Fundacion-Fulgor/IHP__CDR4176/doc/fig/PI_Timeline.png

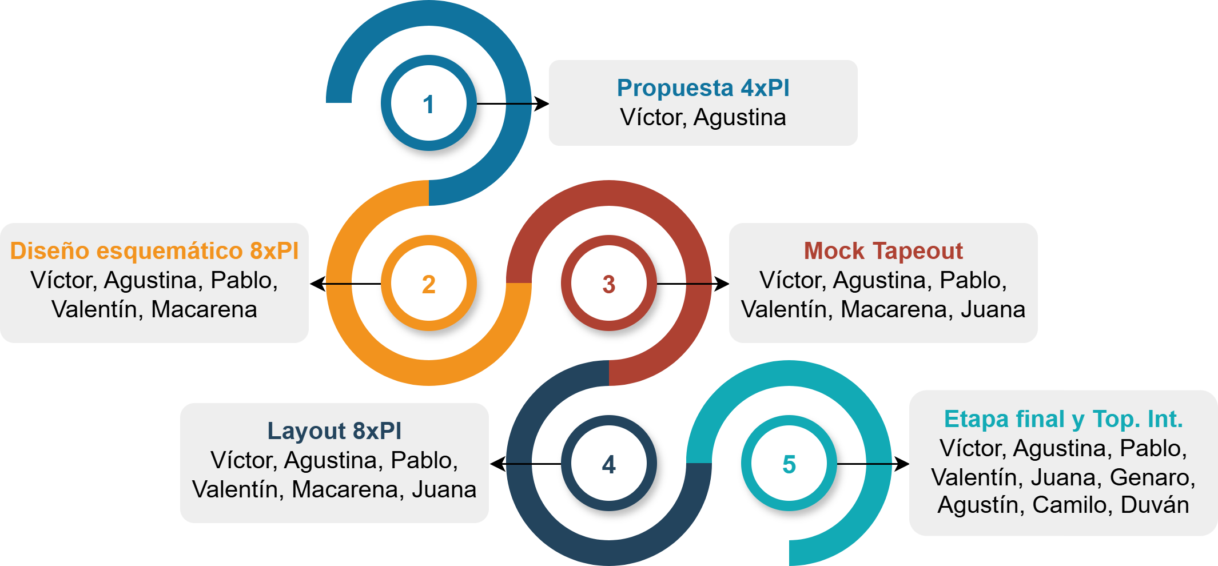
doc/fig/PI_Timeline.png
