Fundacion-Fulgor/IHP__CDR4176/CDR4176-main/schematic/xschem/MUX_4_1_CDR/MUX_4_1_CDR_pex.spice

* NGSPICE file created from MUX_4_1.ext - technology: ihp-sg13g2

.subckt MUX_4_1_CDR_pex VINA VINB VDD VOUT VS[1] VS[0] VINC VSS VIND VST
X0 MUX_2_1_2.tg_custom_6.VOUT MUX_2_1_2.tg_custom_6.VSN.t1 MUX_2_1_2.inv_PI_1.VOUT VSS sg13_lv_nmos ad=0.1005p pd=1.34u as=0.1005p ps=1.34u w=0.15u l=0.13u
X1 MUX_2_1_2.inv_PI_0.VOUT VINA.t0 VDD VDD sg13_lv_pmos ad=55.5f pd=0.74u as=0.1005p ps=1.34u w=0.15u l=0.13u
X2 MUX_2_1_0.inv_PI_1.VOUT MUX_2_1_0.tg_custom_6.VSP.t1 MUX_2_1_0.tg_custom_6.VOUT VDD sg13_lv_pmos ad=0.1005p pd=1.34u as=55.5f ps=0.74u w=0.15u l=0.13u
X3 MUX_2_1_0.VINB MUX_2_1_1.tg_custom_6.VSP.t1 MUX_2_1_1.tg_custom_2.VOUT VSS sg13_lv_nmos ad=0.1005p pd=1.34u as=0.1005p ps=1.34u w=0.15u l=0.13u
X4 a_10276_981# a_10276_981# VSS VSS sg13_lv_nmos ad=0.1005p pd=1.34u as=0.1005p ps=1.34u w=0.15u l=0.13u
X5 VDD VINA.t0 MUX_2_1_2.inv_PI_0.VOUT VDD sg13_lv_pmos ad=55.5f pd=0.74u as=55.5f ps=0.74u w=0.15u l=0.13u
X6 MUX_2_1_2.inv_PI_0.VOUT MUX_2_1_2.tg_custom_6.VSP.t1 MUX_2_1_2.tg_custom_2.VOUT VDD sg13_lv_pmos ad=0.1005p pd=1.34u as=55.5f ps=0.74u w=0.15u l=0.13u
X7 MUX_2_1_2.tg_custom_2.VOUT MUX_2_1_2.tg_custom_4.VSP MUX_2_1_2.inv_PI_0.VOUT VSS sg13_lv_nmos ad=0.1005p pd=1.34u as=0.1005p ps=1.34u w=0.15u l=0.13u
X8 MUX_2_1_1.tg_custom_2.VOUT VS[1].t0 MUX_2_1_1.inv_PI_0.VOUT VDD sg13_lv_pmos ad=55.5f pd=0.74u as=0.1005p ps=1.34u w=0.15u l=0.13u
X9 MUX_2_1_1.inv_PI_0.VOUT VINC.t0 VDD VDD sg13_lv_pmos ad=0.1005p pd=1.34u as=55.5f ps=0.74u w=0.15u l=0.13u
X10 MUX_2_1_1.tg_custom_6.VOUT MUX_2_1_1.tg_custom_4.VSP MUX_2_1_1.inv_PI_1.VOUT VDD sg13_lv_pmos ad=55.5f pd=0.74u as=0.1005p ps=1.34u w=0.15u l=0.13u
X11 MUX_2_1_2.tg_custom_6.VOUT MUX_2_1_2.tg_custom_4.VSP MUX_2_1_2.inv_PI_1.VOUT VDD sg13_lv_pmos ad=55.5f pd=0.74u as=0.1005p ps=1.34u w=0.15u l=0.13u
X12 MUX_2_1_0.inv_PI_0.VOUT MUX_2_1_0.VINA VDD VDD sg13_lv_pmos ad=55.5f pd=0.74u as=0.1005p ps=1.34u w=0.15u l=0.13u
X13 MUX_2_1_0.tg_custom_2.VOUT MUX_2_1_0.tg_custom_4.VSP MUX_2_1_0.inv_PI_0.VOUT VSS sg13_lv_nmos ad=0.1005p pd=1.34u as=0.1005p ps=1.34u w=0.15u l=0.13u
X14 VSS VINA.t0 MUX_2_1_2.inv_PI_0.VOUT VSS sg13_lv_nmos ad=0.1005p pd=1.34u as=55.5f ps=0.74u w=0.15u l=0.13u
X15 MUX_2_1_0.tg_custom_4.VSP VST.t0 VSS VSS sg13_lv_nmos ad=0.1005p pd=1.34u as=0.1005p ps=1.34u w=0.15u l=0.13u
X16 MUX_2_1_0.tg_custom_6.VOUT MUX_2_1_0.tg_custom_4.VSP MUX_2_1_0.inv_PI_1.VOUT VDD sg13_lv_pmos ad=55.5f pd=0.74u as=0.1005p ps=1.34u w=0.15u l=0.13u
X17 VOUT.t3 MUX_2_1_0.tg_custom_6.VSN.t1 MUX_2_1_0.tg_custom_2.VOUT VDD sg13_lv_pmos ad=55.5f pd=0.74u as=0.1005p ps=1.34u w=0.15u l=0.13u
X18 MUX_2_1_0.tg_custom_6.VSP.t0 a_13178_1682# VDD VDD sg13_lv_pmos ad=0.1005p pd=1.34u as=0.1005p ps=1.34u w=0.15u l=0.13u
X19 MUX_2_1_1.inv_PI_1.VOUT MUX_2_1_1.tg_custom_6.VSP.t2 MUX_2_1_1.tg_custom_6.VOUT VDD sg13_lv_pmos ad=0.1005p pd=1.34u as=55.5f ps=0.74u w=0.15u l=0.13u
X20 VSS MUX_2_1_0.VINA MUX_2_1_0.inv_PI_0.VOUT VSS sg13_lv_nmos ad=0.1005p pd=1.34u as=55.5f ps=0.74u w=0.15u l=0.13u
X21 VDD VIND.t0 MUX_2_1_1.inv_PI_1.VOUT VDD sg13_lv_pmos ad=55.5f pd=0.74u as=55.5f ps=0.74u w=0.15u l=0.13u
X22 MUX_2_1_1.tg_custom_6.VSN.t0 a_10276_280# VSS VSS sg13_lv_nmos ad=0.1005p pd=1.34u as=0.1005p ps=1.34u w=0.15u l=0.13u
X23 MUX_2_1_0.inv_PI_1.VOUT MUX_2_1_0.VINB VSS VSS sg13_lv_nmos ad=55.5f pd=0.74u as=0.1005p ps=1.34u w=0.15u l=0.13u
X24 MUX_2_1_0.VINA MUX_2_1_2.tg_custom_6.VSP.t2 MUX_2_1_2.tg_custom_6.VOUT VSS sg13_lv_nmos ad=0.1005p pd=1.34u as=0.1005p ps=1.34u w=0.15u l=0.13u
X25 MUX_2_1_2.tg_custom_6.VSN.t0 a_10276_1682# VSS VSS sg13_lv_nmos ad=0.1005p pd=1.34u as=0.1005p ps=1.34u w=0.15u l=0.13u
X26 MUX_2_1_2.tg_custom_2.VOUT MUX_2_1_2.tg_custom_6.VSN.t2 MUX_2_1_2.inv_PI_0.VOUT VSS sg13_lv_nmos ad=0.1005p pd=1.34u as=0.1005p ps=1.34u w=0.15u l=0.13u
X27 MUX_2_1_1.tg_custom_2.VOUT MUX_2_1_1.tg_custom_6.VSN.t1 MUX_2_1_0.VINB VDD sg13_lv_pmos ad=0.1005p pd=1.34u as=55.5f ps=0.74u w=0.15u l=0.13u
X28 MUX_2_1_1.tg_custom_2.VOUT MUX_2_1_1.tg_custom_6.VSP.t3 MUX_2_1_1.inv_PI_0.VOUT VDD sg13_lv_pmos ad=55.5f pd=0.74u as=0.1005p ps=1.34u w=0.15u l=0.13u
X29 MUX_2_1_2.tg_custom_4.VSP VS[0].t0 VDD VDD sg13_lv_pmos ad=0.1005p pd=1.34u as=0.1005p ps=1.34u w=0.15u l=0.13u
X30 MUX_2_1_1.inv_PI_1.VOUT MUX_2_1_1.tg_custom_4.VSP MUX_2_1_1.tg_custom_6.VOUT VDD sg13_lv_pmos ad=0.1005p pd=1.34u as=55.5f ps=0.74u w=0.15u l=0.13u
X31 MUX_2_1_0.VINB MUX_2_1_1.tg_custom_6.VSN.t2 MUX_2_1_1.tg_custom_6.VOUT VDD sg13_lv_pmos ad=55.5f pd=0.74u as=0.1005p ps=1.34u w=0.15u l=0.13u
X32 MUX_2_1_2.tg_custom_2.VOUT VS[0].t1 MUX_2_1_2.inv_PI_0.VOUT VDD sg13_lv_pmos ad=55.5f pd=0.74u as=0.1005p ps=1.34u w=0.15u l=0.13u
X33 MUX_2_1_0.inv_PI_0.VOUT VST.t1 MUX_2_1_0.tg_custom_2.VOUT VDD sg13_lv_pmos ad=0.1005p pd=1.34u as=55.5f ps=0.74u w=0.15u l=0.13u
X34 MUX_2_1_0.tg_custom_6.VOUT MUX_2_1_0.tg_custom_6.VSN.t2 MUX_2_1_0.inv_PI_1.VOUT VSS sg13_lv_nmos ad=0.1005p pd=1.34u as=0.1005p ps=1.34u w=0.15u l=0.13u
X35 MUX_2_1_1.inv_PI_0.VOUT VINC.t0 VSS VSS sg13_lv_nmos ad=55.5f pd=0.74u as=0.1005p ps=1.34u w=0.15u l=0.13u
X36 MUX_2_1_1.inv_PI_0.VOUT VS[1].t1 MUX_2_1_1.tg_custom_2.VOUT VDD sg13_lv_pmos ad=0.1005p pd=1.34u as=55.5f ps=0.74u w=0.15u l=0.13u
X37 MUX_2_1_2.inv_PI_1.VOUT VINB.t0 VDD VDD sg13_lv_pmos ad=0.1005p pd=1.34u as=55.5f ps=0.74u w=0.15u l=0.13u
X38 MUX_2_1_2.tg_custom_6.VOUT MUX_2_1_2.tg_custom_6.VSP.t3 MUX_2_1_2.inv_PI_1.VOUT VDD sg13_lv_pmos ad=55.5f pd=0.74u as=0.1005p ps=1.34u w=0.15u l=0.13u
X39 MUX_2_1_1.inv_PI_1.VOUT VIND.t0 VDD VDD sg13_lv_pmos ad=55.5f pd=0.74u as=0.1005p ps=1.34u w=0.15u l=0.13u
X40 MUX_2_1_1.inv_PI_1.VOUT VIND.t0 VDD VDD sg13_lv_pmos ad=0.1005p pd=1.34u as=55.5f ps=0.74u w=0.15u l=0.13u
X41 MUX_2_1_0.tg_custom_6.VOUT MUX_2_1_0.tg_custom_6.VSP.t1 MUX_2_1_0.inv_PI_1.VOUT VDD sg13_lv_pmos ad=55.5f pd=0.74u as=0.1005p ps=1.34u w=0.15u l=0.13u
X42 MUX_2_1_0.inv_PI_1.VOUT MUX_2_1_0.VINB VDD VDD sg13_lv_pmos ad=0.1005p pd=1.34u as=55.5f ps=0.74u w=0.15u l=0.13u
X43 MUX_2_1_1.tg_custom_6.VOUT MUX_2_1_1.tg_custom_6.VSP.t4 MUX_2_1_1.inv_PI_1.VOUT VDD sg13_lv_pmos ad=55.5f pd=0.74u as=0.1005p ps=1.34u w=0.15u l=0.13u
X44 MUX_2_1_0.tg_custom_2.VOUT VST.t2 MUX_2_1_0.inv_PI_0.VOUT VDD sg13_lv_pmos ad=55.5f pd=0.74u as=0.1005p ps=1.34u w=0.15u l=0.13u
X45 MUX_2_1_0.inv_PI_1.VOUT MUX_2_1_0.tg_custom_6.VSP.t2 MUX_2_1_0.tg_custom_6.VOUT VDD sg13_lv_pmos ad=0.1005p pd=1.34u as=55.5f ps=0.74u w=0.15u l=0.13u
X46 MUX_2_1_1.tg_custom_6.VOUT MUX_2_1_1.tg_custom_6.VSN.t2 MUX_2_1_0.VINB VDD sg13_lv_pmos ad=0.1005p pd=1.34u as=55.5f ps=0.74u w=0.15u l=0.13u
X47 MUX_2_1_0.inv_PI_0.VOUT MUX_2_1_0.VINA VSS VSS sg13_lv_nmos ad=55.5f pd=0.74u as=0.1005p ps=1.34u w=0.15u l=0.13u
X48 MUX_2_1_1.tg_custom_4.VSP VS[1].t2 VSS VSS sg13_lv_nmos ad=0.1005p pd=1.34u as=0.1005p ps=1.34u w=0.15u l=0.13u
X49 a_10276_2383# a_10276_2383# VSS VSS sg13_lv_nmos ad=0.1005p pd=1.34u as=0.1005p ps=1.34u w=0.15u l=0.13u
X50 MUX_2_1_0.VINA MUX_2_1_2.tg_custom_6.VSP.t4 MUX_2_1_2.tg_custom_2.VOUT VSS sg13_lv_nmos ad=0.1005p pd=1.34u as=0.1005p ps=1.34u w=0.15u l=0.13u
X51 MUX_2_1_0.VINB MUX_2_1_1.tg_custom_6.VSN.t1 MUX_2_1_1.tg_custom_2.VOUT VDD sg13_lv_pmos ad=55.5f pd=0.74u as=0.1005p ps=1.34u w=0.15u l=0.13u
X52 MUX_2_1_1.tg_custom_6.VSP.t0 a_10276_981# VDD VDD sg13_lv_pmos ad=0.1005p pd=1.34u as=0.1005p ps=1.34u w=0.15u l=0.13u
X53 MUX_2_1_1.tg_custom_2.VOUT MUX_2_1_1.tg_custom_4.VSP MUX_2_1_1.inv_PI_0.VOUT VSS sg13_lv_nmos ad=0.1005p pd=1.34u as=0.1005p ps=1.34u w=0.15u l=0.13u
X54 MUX_2_1_2.tg_custom_6.VOUT MUX_2_1_2.tg_custom_6.VSN.t3 MUX_2_1_0.VINA VDD sg13_lv_pmos ad=0.1005p pd=1.34u as=55.5f ps=0.74u w=0.15u l=0.13u
X55 MUX_2_1_0.tg_custom_2.VOUT MUX_2_1_0.tg_custom_6.VSN.t3 MUX_2_1_0.inv_PI_0.VOUT VSS sg13_lv_nmos ad=0.1005p pd=1.34u as=0.1005p ps=1.34u w=0.15u l=0.13u
X56 MUX_2_1_2.tg_custom_6.VOUT MUX_2_1_2.tg_custom_6.VSP.t5 MUX_2_1_2.inv_PI_1.VOUT VDD sg13_lv_pmos ad=55.5f pd=0.74u as=0.1005p ps=1.34u w=0.15u l=0.13u
X57 MUX_2_1_2.inv_PI_1.VOUT VINB.t0 VSS VSS sg13_lv_nmos ad=55.5f pd=0.74u as=0.1005p ps=1.34u w=0.15u l=0.13u
X58 MUX_2_1_2.inv_PI_0.VOUT VINA.t0 VDD VDD sg13_lv_pmos ad=0.1005p pd=1.34u as=55.5f ps=0.74u w=0.15u l=0.13u
X59 MUX_2_1_2.tg_custom_2.VOUT VS[0].t2 MUX_2_1_2.inv_PI_0.VOUT VDD sg13_lv_pmos ad=55.5f pd=0.74u as=0.1005p ps=1.34u w=0.15u l=0.13u
X60 VOUT.t0 MUX_2_1_0.tg_custom_6.VSP.t3 MUX_2_1_0.tg_custom_6.VOUT VSS sg13_lv_nmos ad=0.1005p pd=1.34u as=0.1005p ps=1.34u w=0.15u l=0.13u
X61 MUX_2_1_0.tg_custom_6.VSN.t0 a_13178_981# VSS VSS sg13_lv_nmos ad=0.1005p pd=1.34u as=0.1005p ps=1.34u w=0.15u l=0.13u
X62 MUX_2_1_1.inv_PI_1.VOUT MUX_2_1_1.tg_custom_6.VSP.t4 MUX_2_1_1.tg_custom_6.VOUT VDD sg13_lv_pmos ad=0.1005p pd=1.34u as=55.5f ps=0.74u w=0.15u l=0.13u
X63 MUX_2_1_1.inv_PI_0.VOUT VS[1].t0 MUX_2_1_1.tg_custom_2.VOUT VDD sg13_lv_pmos ad=0.1005p pd=1.34u as=55.5f ps=0.74u w=0.15u l=0.13u
X64 MUX_2_1_2.inv_PI_1.VOUT MUX_2_1_2.tg_custom_4.VSP MUX_2_1_2.tg_custom_6.VOUT VDD sg13_lv_pmos ad=0.1005p pd=1.34u as=55.5f ps=0.74u w=0.15u l=0.13u
X65 MUX_2_1_0.inv_PI_1.VOUT MUX_2_1_0.tg_custom_4.VSP MUX_2_1_0.tg_custom_6.VOUT VDD sg13_lv_pmos ad=0.1005p pd=1.34u as=55.5f ps=0.74u w=0.15u l=0.13u
X66 MUX_2_1_1.tg_custom_6.VOUT MUX_2_1_1.tg_custom_6.VSN.t3 MUX_2_1_1.inv_PI_1.VOUT VSS sg13_lv_nmos ad=0.1005p pd=1.34u as=0.1005p ps=1.34u w=0.15u l=0.13u
X67 VDD MUX_2_1_0.VINB MUX_2_1_0.inv_PI_1.VOUT VDD sg13_lv_pmos ad=55.5f pd=0.74u as=55.5f ps=0.74u w=0.15u l=0.13u
X68 MUX_2_1_0.tg_custom_2.VOUT VST.t1 MUX_2_1_0.inv_PI_0.VOUT VDD sg13_lv_pmos ad=55.5f pd=0.74u as=0.1005p ps=1.34u w=0.15u l=0.13u
X69 MUX_2_1_0.inv_PI_0.VOUT MUX_2_1_0.VINA VDD VDD sg13_lv_pmos ad=0.1005p pd=1.34u as=55.5f ps=0.74u w=0.15u l=0.13u
X70 MUX_2_1_0.tg_custom_4.VSP VST.t0 VDD VDD sg13_lv_pmos ad=0.1005p pd=1.34u as=0.1005p ps=1.34u w=0.15u l=0.13u
X71 a_10276_280# a_10276_280# VDD VDD sg13_lv_pmos ad=0.1005p pd=1.34u as=0.1005p ps=1.34u w=0.15u l=0.13u
X72 MUX_2_1_1.inv_PI_0.VOUT VINC.t0 VDD VDD sg13_lv_pmos ad=55.5f pd=0.74u as=0.1005p ps=1.34u w=0.15u l=0.13u
X73 MUX_2_1_0.inv_PI_0.VOUT MUX_2_1_0.tg_custom_6.VSP.t4 MUX_2_1_0.tg_custom_2.VOUT VDD sg13_lv_pmos ad=0.1005p pd=1.34u as=55.5f ps=0.74u w=0.15u l=0.13u
X74 MUX_2_1_2.tg_custom_2.VOUT MUX_2_1_2.tg_custom_6.VSN.t4 MUX_2_1_0.VINA VDD sg13_lv_pmos ad=0.1005p pd=1.34u as=55.5f ps=0.74u w=0.15u l=0.13u
X75 MUX_2_1_2.tg_custom_6.VOUT VS[0].t3 MUX_2_1_2.inv_PI_1.VOUT VSS sg13_lv_nmos ad=0.1005p pd=1.34u as=0.1005p ps=1.34u w=0.15u l=0.13u
X76 MUX_2_1_2.tg_custom_2.VOUT MUX_2_1_2.tg_custom_6.VSP.t1 MUX_2_1_2.inv_PI_0.VOUT VDD sg13_lv_pmos ad=55.5f pd=0.74u as=0.1005p ps=1.34u w=0.15u l=0.13u
X77 VDD VINC.t0 MUX_2_1_1.inv_PI_0.VOUT VDD sg13_lv_pmos ad=55.5f pd=0.74u as=55.5f ps=0.74u w=0.15u l=0.13u
X78 MUX_2_1_1.inv_PI_0.VOUT MUX_2_1_1.tg_custom_6.VSP.t3 MUX_2_1_1.tg_custom_2.VOUT VDD sg13_lv_pmos ad=0.1005p pd=1.34u as=55.5f ps=0.74u w=0.15u l=0.13u
X79 MUX_2_1_1.tg_custom_6.VOUT VS[1].t3 MUX_2_1_1.inv_PI_1.VOUT VSS sg13_lv_nmos ad=0.1005p pd=1.34u as=0.1005p ps=1.34u w=0.15u l=0.13u
X80 MUX_2_1_1.tg_custom_2.VOUT MUX_2_1_1.tg_custom_4.VSP MUX_2_1_1.inv_PI_0.VOUT VSS sg13_lv_nmos ad=0.1005p pd=1.34u as=0.1005p ps=1.34u w=0.15u l=0.13u
X81 VOUT.t1 MUX_2_1_0.tg_custom_6.VSP.t5 MUX_2_1_0.tg_custom_2.VOUT VSS sg13_lv_nmos ad=0.1005p pd=1.34u as=0.1005p ps=1.34u w=0.15u l=0.13u
X82 a_13178_1682# a_13178_1682# VSS VSS sg13_lv_nmos ad=0.1005p pd=1.34u as=0.1005p ps=1.34u w=0.15u l=0.13u
X83 MUX_2_1_0.VINA MUX_2_1_2.tg_custom_6.VSN.t3 MUX_2_1_2.tg_custom_6.VOUT VDD sg13_lv_pmos ad=55.5f pd=0.74u as=0.1005p ps=1.34u w=0.15u l=0.13u
X84 a_10276_1682# a_10276_1682# VDD VDD sg13_lv_pmos ad=0.1005p pd=1.34u as=0.1005p ps=1.34u w=0.15u l=0.13u
X85 MUX_2_1_0.tg_custom_6.VOUT MUX_2_1_0.tg_custom_6.VSN.t4 VOUT.t2 VDD sg13_lv_pmos ad=0.1005p pd=1.34u as=55.5f ps=0.74u w=0.15u l=0.13u
X86 MUX_2_1_0.tg_custom_6.VOUT MUX_2_1_0.tg_custom_6.VSP.t2 MUX_2_1_0.inv_PI_1.VOUT VDD sg13_lv_pmos ad=55.5f pd=0.74u as=0.1005p ps=1.34u w=0.15u l=0.13u
X87 MUX_2_1_2.inv_PI_0.VOUT VINA.t0 VSS VSS sg13_lv_nmos ad=55.5f pd=0.74u as=0.1005p ps=1.34u w=0.15u l=0.13u
X88 MUX_2_1_2.inv_PI_0.VOUT VS[0].t1 MUX_2_1_2.tg_custom_2.VOUT VDD sg13_lv_pmos ad=0.1005p pd=1.34u as=55.5f ps=0.74u w=0.15u l=0.13u
X89 MUX_2_1_0.tg_custom_6.VOUT VST.t3 MUX_2_1_0.inv_PI_1.VOUT VSS sg13_lv_nmos ad=0.1005p pd=1.34u as=0.1005p ps=1.34u w=0.15u l=0.13u
X90 VSS VINC.t0 MUX_2_1_1.inv_PI_0.VOUT VSS sg13_lv_nmos ad=0.1005p pd=1.34u as=55.5f ps=0.74u w=0.15u l=0.13u
X91 MUX_2_1_2.inv_PI_1.VOUT MUX_2_1_2.tg_custom_6.VSP.t3 MUX_2_1_2.tg_custom_6.VOUT VDD sg13_lv_pmos ad=0.1005p pd=1.34u as=55.5f ps=0.74u w=0.15u l=0.13u
X92 MUX_2_1_0.inv_PI_0.VOUT VST.t2 MUX_2_1_0.tg_custom_2.VOUT VDD sg13_lv_pmos ad=0.1005p pd=1.34u as=55.5f ps=0.74u w=0.15u l=0.13u
X93 VDD MUX_2_1_0.VINA MUX_2_1_0.inv_PI_0.VOUT VDD sg13_lv_pmos ad=55.5f pd=0.74u as=55.5f ps=0.74u w=0.15u l=0.13u
X94 MUX_2_1_1.inv_PI_1.VOUT VIND.t0 VSS VSS sg13_lv_nmos ad=55.5f pd=0.74u as=0.1005p ps=1.34u w=0.15u l=0.13u
X95 MUX_2_1_1.tg_custom_2.VOUT MUX_2_1_1.tg_custom_6.VSN.t4 MUX_2_1_1.inv_PI_0.VOUT VSS sg13_lv_nmos ad=0.1005p pd=1.34u as=0.1005p ps=1.34u w=0.15u l=0.13u
X96 MUX_2_1_2.tg_custom_4.VSP VS[0].t0 VSS VSS sg13_lv_nmos ad=0.1005p pd=1.34u as=0.1005p ps=1.34u w=0.15u l=0.13u
X97 MUX_2_1_1.tg_custom_4.VSP VS[1].t2 VDD VDD sg13_lv_pmos ad=0.1005p pd=1.34u as=0.1005p ps=1.34u w=0.15u l=0.13u
X98 MUX_2_1_2.inv_PI_1.VOUT VINB.t0 VDD VDD sg13_lv_pmos ad=55.5f pd=0.74u as=0.1005p ps=1.34u w=0.15u l=0.13u
X99 MUX_2_1_2.tg_custom_6.VSP.t0 a_10276_2383# VDD VDD sg13_lv_pmos ad=0.1005p pd=1.34u as=0.1005p ps=1.34u w=0.15u l=0.13u
X100 MUX_2_1_0.VINA MUX_2_1_2.tg_custom_6.VSN.t4 MUX_2_1_2.tg_custom_2.VOUT VDD sg13_lv_pmos ad=55.5f pd=0.74u as=0.1005p ps=1.34u w=0.15u l=0.13u
X101 MUX_2_1_0.VINB MUX_2_1_1.tg_custom_6.VSP.t5 MUX_2_1_1.tg_custom_6.VOUT VSS sg13_lv_nmos ad=0.1005p pd=1.34u as=0.1005p ps=1.34u w=0.15u l=0.13u
X102 MUX_2_1_2.tg_custom_6.VOUT MUX_2_1_2.tg_custom_6.VSN.t5 MUX_2_1_2.inv_PI_1.VOUT VSS sg13_lv_nmos ad=0.1005p pd=1.34u as=0.1005p ps=1.34u w=0.15u l=0.13u
X103 MUX_2_1_2.tg_custom_2.VOUT MUX_2_1_2.tg_custom_4.VSP MUX_2_1_2.inv_PI_0.VOUT VSS sg13_lv_nmos ad=0.1005p pd=1.34u as=0.1005p ps=1.34u w=0.15u l=0.13u
X104 MUX_2_1_1.tg_custom_2.VOUT VS[1].t1 MUX_2_1_1.inv_PI_0.VOUT VDD sg13_lv_pmos ad=55.5f pd=0.74u as=0.1005p ps=1.34u w=0.15u l=0.13u
X105 VDD VINB.t0 MUX_2_1_2.inv_PI_1.VOUT VDD sg13_lv_pmos ad=55.5f pd=0.74u as=55.5f ps=0.74u w=0.15u l=0.13u
X106 MUX_2_1_0.inv_PI_1.VOUT MUX_2_1_0.VINB VDD VDD sg13_lv_pmos ad=55.5f pd=0.74u as=0.1005p ps=1.34u w=0.15u l=0.13u
X107 MUX_2_1_2.inv_PI_1.VOUT MUX_2_1_2.tg_custom_6.VSP.t5 MUX_2_1_2.tg_custom_6.VOUT VDD sg13_lv_pmos ad=0.1005p pd=1.34u as=55.5f ps=0.74u w=0.15u l=0.13u
X108 MUX_2_1_0.tg_custom_2.VOUT MUX_2_1_0.tg_custom_4.VSP MUX_2_1_0.inv_PI_0.VOUT VSS sg13_lv_nmos ad=0.1005p pd=1.34u as=0.1005p ps=1.34u w=0.15u l=0.13u
X109 VSS VINB.t0 MUX_2_1_2.inv_PI_1.VOUT VSS sg13_lv_nmos ad=0.1005p pd=1.34u as=55.5f ps=0.74u w=0.15u l=0.13u
X110 VOUT.t2 MUX_2_1_0.tg_custom_6.VSN.t4 MUX_2_1_0.tg_custom_6.VOUT VDD sg13_lv_pmos ad=55.5f pd=0.74u as=0.1005p ps=1.34u w=0.15u l=0.13u
X111 a_13178_981# a_13178_981# VDD VDD sg13_lv_pmos ad=0.1005p pd=1.34u as=0.1005p ps=1.34u w=0.15u l=0.13u
X112 MUX_2_1_0.tg_custom_2.VOUT MUX_2_1_0.tg_custom_6.VSN.t1 VOUT.t3 VDD sg13_lv_pmos ad=0.1005p pd=1.34u as=55.5f ps=0.74u w=0.15u l=0.13u
X113 MUX_2_1_0.tg_custom_2.VOUT MUX_2_1_0.tg_custom_6.VSP.t4 MUX_2_1_0.inv_PI_0.VOUT VDD sg13_lv_pmos ad=55.5f pd=0.74u as=0.1005p ps=1.34u w=0.15u l=0.13u
X114 MUX_2_1_2.inv_PI_0.VOUT VS[0].t2 MUX_2_1_2.tg_custom_2.VOUT VDD sg13_lv_pmos ad=0.1005p pd=1.34u as=55.5f ps=0.74u w=0.15u l=0.13u
X115 MUX_2_1_0.tg_custom_6.VOUT MUX_2_1_0.tg_custom_6.VSN.t5 MUX_2_1_0.inv_PI_1.VOUT VSS sg13_lv_nmos ad=0.1005p pd=1.34u as=0.1005p ps=1.34u w=0.15u l=0.13u
X116 MUX_2_1_1.tg_custom_6.VOUT MUX_2_1_1.tg_custom_6.VSN.t5 MUX_2_1_1.inv_PI_1.VOUT VSS sg13_lv_nmos ad=0.1005p pd=1.34u as=0.1005p ps=1.34u w=0.15u l=0.13u
X117 VSS VIND.t0 MUX_2_1_1.inv_PI_1.VOUT VSS sg13_lv_nmos ad=0.1005p pd=1.34u as=55.5f ps=0.74u w=0.15u l=0.13u
X118 MUX_2_1_1.tg_custom_6.VOUT MUX_2_1_1.tg_custom_6.VSP.t2 MUX_2_1_1.inv_PI_1.VOUT VDD sg13_lv_pmos ad=55.5f pd=0.74u as=0.1005p ps=1.34u w=0.15u l=0.13u
X119 VSS MUX_2_1_0.VINB MUX_2_1_0.inv_PI_1.VOUT VSS sg13_lv_nmos ad=0.1005p pd=1.34u as=55.5f ps=0.74u w=0.15u l=0.13u
R0 MUX_2_1_2.tg_custom_6.VSN.n1 MUX_2_1_2.tg_custom_6.VSN 36.9663
R1 MUX_2_1_2.tg_custom_6.VSN.n0 MUX_2_1_2.tg_custom_6.VSN 27.9685
R2 MUX_2_1_2.tg_custom_6.VSN.n2 MUX_2_1_2.tg_custom_6.VSN 27.0005
R3 MUX_2_1_2.tg_custom_6.VSN.n0 MUX_2_1_2.tg_custom_6.VSN 27.0005
R4 MUX_2_1_2.tg_custom_6.VSN.n3 MUX_2_1_2.tg_custom_6.VSN 18.6611
R5 MUX_2_1_2.tg_custom_6.VSN.n4 MUX_2_1_2.tg_custom_6.VSN.n3 18.3649
R6 MUX_2_1_2.tg_custom_6.VSN.n4 MUX_2_1_2.tg_custom_6.VSN.t0 17.0005
R7 MUX_2_1_2.tg_custom_6.VSN MUX_2_1_2.tg_custom_6.VSN.t1 15.0005
R8 MUX_2_1_2.tg_custom_6.VSN MUX_2_1_2.tg_custom_6.VSN.t3 15.0005
R9 MUX_2_1_2.tg_custom_6.VSN MUX_2_1_2.tg_custom_6.VSN.t2 15.0005
R10 MUX_2_1_2.tg_custom_6.VSN MUX_2_1_2.tg_custom_6.VSN.t4 15.0005
R11 MUX_2_1_2.tg_custom_6.VSN MUX_2_1_2.tg_custom_6.VSN.t5 15.0005
R12 MUX_2_1_2.tg_custom_6.VSN.n1 MUX_2_1_2.tg_custom_6.VSN.n0 10.0641
R13 MUX_2_1_2.tg_custom_6.VSN.n3 MUX_2_1_2.tg_custom_6.VSN.n2 9.8101
R14 MUX_2_1_2.tg_custom_6.VSN.n2 MUX_2_1_2.tg_custom_6.VSN.n1 9.0005
R15 MUX_2_1_2.tg_custom_6.VSN MUX_2_1_2.tg_custom_6.VSN.n4 0.0108125
R16 VINA.n0 VINA.t0 15.0005
R17 VINA.n0 VINA 9.52166
R18 VINA VINA.n0 0.0225
R19 MUX_2_1_0.tg_custom_6.VSP.n0 MUX_2_1_0.tg_custom_6.VSP 64.0301
R20 MUX_2_1_0.tg_custom_6.VSP.n1 MUX_2_1_0.tg_custom_6.VSP 46.0301
R21 MUX_2_1_0.tg_custom_6.VSP.n3 MUX_2_1_0.tg_custom_6.VSP.n2 37.0641
R22 MUX_2_1_0.tg_custom_6.VSP MUX_2_1_0.tg_custom_6.VSP.t0 17.0177
R23 MUX_2_1_0.tg_custom_6.VSP MUX_2_1_0.tg_custom_6.VSP.t1 15.0005
R24 MUX_2_1_0.tg_custom_6.VSP MUX_2_1_0.tg_custom_6.VSP.t2 15.0005
R25 MUX_2_1_0.tg_custom_6.VSP MUX_2_1_0.tg_custom_6.VSP.t3 15.0005
R26 MUX_2_1_0.tg_custom_6.VSP MUX_2_1_0.tg_custom_6.VSP.t4 15.0005
R27 MUX_2_1_0.tg_custom_6.VSP MUX_2_1_0.tg_custom_6.VSP.t5 15.0005
R28 MUX_2_1_0.tg_custom_6.VSP.n2 MUX_2_1_0.tg_custom_6.VSP 9.66547
R29 MUX_2_1_0.tg_custom_6.VSP.n4 MUX_2_1_0.tg_custom_6.VSP.n3 9.53876
R30 MUX_2_1_0.tg_custom_6.VSP.n1 MUX_2_1_0.tg_custom_6.VSP 9.0005
R31 MUX_2_1_0.tg_custom_6.VSP.n0 MUX_2_1_0.tg_custom_6.VSP 9.0005
R32 MUX_2_1_0.tg_custom_6.VSP.n2 MUX_2_1_0.tg_custom_6.VSP.n1 0.7749
R33 MUX_2_1_0.tg_custom_6.VSP.n3 MUX_2_1_0.tg_custom_6.VSP.n0 0.7749
R34 MUX_2_1_0.tg_custom_6.VSP MUX_2_1_0.tg_custom_6.VSP.n4 0.1105
R35 MUX_2_1_0.tg_custom_6.VSP.n4 MUX_2_1_0.tg_custom_6.VSP 0.0726875
R36 MUX_2_1_0.tg_custom_6.VSP.n4 MUX_2_1_0.tg_custom_6.VSP 0.0555
R37 MUX_2_1_1.tg_custom_6.VSP.n0 MUX_2_1_1.tg_custom_6.VSP 64.0301
R38 MUX_2_1_1.tg_custom_6.VSP.n1 MUX_2_1_1.tg_custom_6.VSP 46.0301
R39 MUX_2_1_1.tg_custom_6.VSP.n3 MUX_2_1_1.tg_custom_6.VSP.n2 37.0641
R40 MUX_2_1_1.tg_custom_6.VSP MUX_2_1_1.tg_custom_6.VSP.t0 17.0177
R41 MUX_2_1_1.tg_custom_6.VSP MUX_2_1_1.tg_custom_6.VSP.t2 15.0005
R42 MUX_2_1_1.tg_custom_6.VSP MUX_2_1_1.tg_custom_6.VSP.t4 15.0005
R43 MUX_2_1_1.tg_custom_6.VSP MUX_2_1_1.tg_custom_6.VSP.t5 15.0005
R44 MUX_2_1_1.tg_custom_6.VSP MUX_2_1_1.tg_custom_6.VSP.t3 15.0005
R45 MUX_2_1_1.tg_custom_6.VSP MUX_2_1_1.tg_custom_6.VSP.t1 15.0005
R46 MUX_2_1_1.tg_custom_6.VSP.n2 MUX_2_1_1.tg_custom_6.VSP 9.66547
R47 MUX_2_1_1.tg_custom_6.VSP.n4 MUX_2_1_1.tg_custom_6.VSP.n3 9.53876
R48 MUX_2_1_1.tg_custom_6.VSP.n1 MUX_2_1_1.tg_custom_6.VSP 9.0005
R49 MUX_2_1_1.tg_custom_6.VSP.n0 MUX_2_1_1.tg_custom_6.VSP 9.0005
R50 MUX_2_1_1.tg_custom_6.VSP.n2 MUX_2_1_1.tg_custom_6.VSP.n1 0.7749
R51 MUX_2_1_1.tg_custom_6.VSP.n3 MUX_2_1_1.tg_custom_6.VSP.n0 0.7749
R52 MUX_2_1_1.tg_custom_6.VSP MUX_2_1_1.tg_custom_6.VSP.n4 0.1105
R53 MUX_2_1_1.tg_custom_6.VSP.n4 MUX_2_1_1.tg_custom_6.VSP 0.0726875
R54 MUX_2_1_1.tg_custom_6.VSP.n4 MUX_2_1_1.tg_custom_6.VSP 0.0555
R55 MUX_2_1_2.tg_custom_6.VSP.n0 MUX_2_1_2.tg_custom_6.VSP 64.0301
R56 MUX_2_1_2.tg_custom_6.VSP.n1 MUX_2_1_2.tg_custom_6.VSP 46.0301
R57 MUX_2_1_2.tg_custom_6.VSP.n3 MUX_2_1_2.tg_custom_6.VSP.n2 37.0641
R58 MUX_2_1_2.tg_custom_6.VSP MUX_2_1_2.tg_custom_6.VSP.t0 17.0177
R59 MUX_2_1_2.tg_custom_6.VSP MUX_2_1_2.tg_custom_6.VSP.t3 15.0005
R60 MUX_2_1_2.tg_custom_6.VSP MUX_2_1_2.tg_custom_6.VSP.t5 15.0005
R61 MUX_2_1_2.tg_custom_6.VSP MUX_2_1_2.tg_custom_6.VSP.t2 15.0005
R62 MUX_2_1_2.tg_custom_6.VSP MUX_2_1_2.tg_custom_6.VSP.t1 15.0005
R63 MUX_2_1_2.tg_custom_6.VSP MUX_2_1_2.tg_custom_6.VSP.t4 15.0005
R64 MUX_2_1_2.tg_custom_6.VSP.n2 MUX_2_1_2.tg_custom_6.VSP 9.66547
R65 MUX_2_1_2.tg_custom_6.VSP.n4 MUX_2_1_2.tg_custom_6.VSP.n3 9.53876
R66 MUX_2_1_2.tg_custom_6.VSP.n1 MUX_2_1_2.tg_custom_6.VSP 9.0005
R67 MUX_2_1_2.tg_custom_6.VSP.n0 MUX_2_1_2.tg_custom_6.VSP 9.0005
R68 MUX_2_1_2.tg_custom_6.VSP.n2 MUX_2_1_2.tg_custom_6.VSP.n1 0.7749
R69 MUX_2_1_2.tg_custom_6.VSP.n3 MUX_2_1_2.tg_custom_6.VSP.n0 0.7749
R70 MUX_2_1_2.tg_custom_6.VSP MUX_2_1_2.tg_custom_6.VSP.n4 0.1105
R71 MUX_2_1_2.tg_custom_6.VSP.n4 MUX_2_1_2.tg_custom_6.VSP 0.0726875
R72 MUX_2_1_2.tg_custom_6.VSP.n4 MUX_2_1_2.tg_custom_6.VSP 0.0555
R73 VS[1].n2 VS[1] 49.0942
R74 VS[1] VS[1].n3 27.9069
R75 VS[1].n3 VS[1] 27.0005
R76 VS[1].n1 VS[1].n0 18.0005
R77 VS[1].n0 VS[1].t2 15.0005
R78 VS[1] VS[1].t3 15.0005
R79 VS[1] VS[1].t1 15.0005
R80 VS[1] VS[1].t0 15.0005
R81 VS[1].n2 VS[1].n1 9.0005
R82 VS[1].n3 VS[1].n2 2.40396
R83 VS[1].n1 VS[1] 0.173241
R84 VS[1].n0 VS[1] 0.0151667
R85 VINC.n0 VINC.t0 15.0005
R86 VINC.n0 VINC 9.52166
R87 VINC VINC.n0 0.0225
R88 VST.n2 VST 49.0942
R89 VST VST.n3 27.9069
R90 VST.n3 VST 27.0005
R91 VST.n0 VST.t0 15.0005
R92 VST VST.t3 15.0005
R93 VST VST.t2 15.0005
R94 VST VST.t1 15.0005
R95 VST.n1 VST.n0 13.5274
R96 VST.n2 VST.n1 9.08525
R97 VST.n2 VST 4.53004
R98 VST.n3 VST.n2 2.40396
R99 VST.n1 VST 0.087878
R100 VST.n0 VST 0.0151667
R101 MUX_2_1_0.tg_custom_6.VSN.n1 MUX_2_1_0.tg_custom_6.VSN 36.9663
R102 MUX_2_1_0.tg_custom_6.VSN.n0 MUX_2_1_0.tg_custom_6.VSN 27.9685
R103 MUX_2_1_0.tg_custom_6.VSN.n2 MUX_2_1_0.tg_custom_6.VSN 27.0005
R104 MUX_2_1_0.tg_custom_6.VSN.n0 MUX_2_1_0.tg_custom_6.VSN 27.0005
R105 MUX_2_1_0.tg_custom_6.VSN.n3 MUX_2_1_0.tg_custom_6.VSN 18.6611
R106 MUX_2_1_0.tg_custom_6.VSN.n4 MUX_2_1_0.tg_custom_6.VSN.n3 18.3649
R107 MUX_2_1_0.tg_custom_6.VSN.n4 MUX_2_1_0.tg_custom_6.VSN.t0 17.0005
R108 MUX_2_1_0.tg_custom_6.VSN MUX_2_1_0.tg_custom_6.VSN.t2 15.0005
R109 MUX_2_1_0.tg_custom_6.VSN MUX_2_1_0.tg_custom_6.VSN.t4 15.0005
R110 MUX_2_1_0.tg_custom_6.VSN MUX_2_1_0.tg_custom_6.VSN.t3 15.0005
R111 MUX_2_1_0.tg_custom_6.VSN MUX_2_1_0.tg_custom_6.VSN.t1 15.0005
R112 MUX_2_1_0.tg_custom_6.VSN MUX_2_1_0.tg_custom_6.VSN.t5 15.0005
R113 MUX_2_1_0.tg_custom_6.VSN.n1 MUX_2_1_0.tg_custom_6.VSN.n0 10.0641
R114 MUX_2_1_0.tg_custom_6.VSN.n3 MUX_2_1_0.tg_custom_6.VSN.n2 9.8101
R115 MUX_2_1_0.tg_custom_6.VSN.n2 MUX_2_1_0.tg_custom_6.VSN.n1 9.0005
R116 MUX_2_1_0.tg_custom_6.VSN MUX_2_1_0.tg_custom_6.VSN.n4 0.0108125
R117 VOUT.n4 VOUT.n3 18.2997
R118 VOUT.n5 VOUT.n4 18.2987
R119 VOUT VOUT.t2 17.7739
R120 VOUT VOUT.t3 17.7739
R121 VOUT.n3 VOUT.t0 17.0005
R122 VOUT.n5 VOUT.t1 17.0005
R123 VOUT.n2 VOUT 0.3525
R124 VOUT.n6 VOUT 0.3525
R125 VOUT.n1 VOUT 0.162063
R126 VOUT.n0 VOUT 0.162063
R127 VOUT.n1 VOUT 0.15175
R128 VOUT.n0 VOUT 0.15175
R129 VOUT.n4 VOUT 0.112944
R130 VOUT.n3 VOUT.n1 0.0403276
R131 VOUT.n3 VOUT.n2 0.0403276
R132 VOUT.n5 VOUT.n0 0.0403276
R133 VOUT.n6 VOUT.n5 0.0403276
R134 VOUT.n2 VOUT 0.00998276
R135 VOUT VOUT.n6 0.00998276
R136 VIND.n0 VIND.t0 15.0005
R137 VIND.n0 VIND 9.52166
R138 VIND VIND.n0 0.0225
R139 MUX_2_1_1.tg_custom_6.VSN.n1 MUX_2_1_1.tg_custom_6.VSN 36.9663
R140 MUX_2_1_1.tg_custom_6.VSN.n0 MUX_2_1_1.tg_custom_6.VSN 27.9685
R141 MUX_2_1_1.tg_custom_6.VSN.n2 MUX_2_1_1.tg_custom_6.VSN 27.0005
R142 MUX_2_1_1.tg_custom_6.VSN.n0 MUX_2_1_1.tg_custom_6.VSN 27.0005
R143 MUX_2_1_1.tg_custom_6.VSN.n3 MUX_2_1_1.tg_custom_6.VSN 18.6611
R144 MUX_2_1_1.tg_custom_6.VSN.n4 MUX_2_1_1.tg_custom_6.VSN.n3 18.3649
R145 MUX_2_1_1.tg_custom_6.VSN.n4 MUX_2_1_1.tg_custom_6.VSN.t0 17.0005
R146 MUX_2_1_1.tg_custom_6.VSN MUX_2_1_1.tg_custom_6.VSN.t5 15.0005
R147 MUX_2_1_1.tg_custom_6.VSN MUX_2_1_1.tg_custom_6.VSN.t2 15.0005
R148 MUX_2_1_1.tg_custom_6.VSN MUX_2_1_1.tg_custom_6.VSN.t4 15.0005
R149 MUX_2_1_1.tg_custom_6.VSN MUX_2_1_1.tg_custom_6.VSN.t1 15.0005
R150 MUX_2_1_1.tg_custom_6.VSN MUX_2_1_1.tg_custom_6.VSN.t3 15.0005
R151 MUX_2_1_1.tg_custom_6.VSN.n1 MUX_2_1_1.tg_custom_6.VSN.n0 10.0641
R152 MUX_2_1_1.tg_custom_6.VSN.n3 MUX_2_1_1.tg_custom_6.VSN.n2 9.8101
R153 MUX_2_1_1.tg_custom_6.VSN.n2 MUX_2_1_1.tg_custom_6.VSN.n1 9.0005
R154 MUX_2_1_1.tg_custom_6.VSN MUX_2_1_1.tg_custom_6.VSN.n4 0.0108125
R155 VS[0].n2 VS[0] 49.0942
R156 VS[0] VS[0].n3 27.9069
R157 VS[0].n3 VS[0] 27.0005
R158 VS[0].n1 VS[0].n0 18.0005
R159 VS[0].n0 VS[0].t0 15.0005
R160 VS[0] VS[0].t3 15.0005
R161 VS[0] VS[0].t1 15.0005
R162 VS[0] VS[0].t2 15.0005
R163 VS[0].n2 VS[0].n1 9.0005
R164 VS[0].n3 VS[0].n2 2.40396
R165 VS[0].n1 VS[0] 0.173241
R166 VS[0].n0 VS[0] 0.0151667
R167 VINB.n0 VINB.t0 15.0005
R168 VINB.n0 VINB 9.52166
R169 VINB VINB.n0 0.0225
C0 MUX_2_1_1.tg_custom_2.VOUT MUX_2_1_1.tg_custom_6.VSN 0.20859f
C1 a_12582_1576# VDD -0
C2 MUX_2_1_1.tg_custom_2.VOUT MUX_2_1_1.inv_PI_0.VOUT 0.75631f
C3 MUX_2_1_1.tg_custom_6.VSP MUX_2_1_1.tg_custom_4.VSP 0.03351f
C4 MUX_2_1_1.tg_custom_6.VSN VIND 0
C5 MUX_2_1_0.tg_custom_4.VSP VDD 0.65753f
C6 MUX_2_1_2.tg_custom_6.VOUT a_10802_1576# -0
C7 VS[0] VINC 0.00482f
C8 VINC VINB 0.0569f
C9 VINA MUX_2_1_2.tg_custom_2.VOUT 0.00187f
C10 MUX_2_1_0.tg_custom_6.VSN VST 0.0304f
C11 MUX_2_1_0.VINA MUX_2_1_2.inv_PI_1.VOUT 0.00609f
C12 VS[0] MUX_2_1_2.inv_PI_0.VOUT 0.22053f
C13 a_13178_981# MUX_2_1_0.tg_custom_6.VSP 0.05112f
C14 MUX_2_1_1.tg_custom_6.VSN MUX_2_1_1.tg_custom_6.VOUT 0.45581f
C15 a_10802_174# MUX_2_1_1.tg_custom_6.VOUT -0
C16 MUX_2_1_0.inv_PI_1.VOUT MUX_2_1_0.tg_custom_6.VSN 0.08394f
C17 MUX_2_1_0.tg_custom_4.VSP MUX_2_1_2.inv_PI_1.VOUT 0
C18 VST VOUT 0
C19 a_10276_1682# MUX_2_1_2.tg_custom_4.VSP 0
C20 VS[0] MUX_2_1_1.inv_PI_1.VOUT 0.00129f
C21 MUX_2_1_0.tg_custom_6.VOUT a_12582_875# -0
C22 MUX_2_1_2.inv_PI_1.VOUT VDD 0.94022f
C23 MUX_2_1_0.tg_custom_6.VOUT a_13292_875# -0
C24 a_10276_2383# MUX_2_1_2.tg_custom_4.VSP 0.0206f
C25 MUX_2_1_2.tg_custom_6.VOUT a_10276_981# 0
C26 MUX_2_1_0.inv_PI_1.VOUT VOUT 0.00572f
C27 VS[0] MUX_2_1_2.tg_custom_6.VSP 0.03177f
C28 MUX_2_1_0.tg_custom_6.VOUT VST 0.12971f
C29 VINB MUX_2_1_2.tg_custom_6.VSP 0
C30 MUX_2_1_1.tg_custom_2.VOUT VST 0.00196f
C31 MUX_2_1_2.tg_custom_6.VOUT MUX_2_1_1.tg_custom_4.VSP 0
C32 VST MUX_2_1_2.tg_custom_2.VOUT 0.00291f
C33 a_13178_981# MUX_2_1_0.tg_custom_6.VSN 0.06058f
C34 MUX_2_1_0.inv_PI_1.VOUT MUX_2_1_0.tg_custom_6.VOUT 0.72287f
C35 MUX_2_1_0.inv_PI_1.VOUT MUX_2_1_1.tg_custom_2.VOUT 0.00356f
C36 MUX_2_1_1.tg_custom_2.VOUT VINC 0.00187f
C37 VINC VIND 0.02923f
C38 MUX_2_1_2.inv_PI_0.VOUT MUX_2_1_2.tg_custom_2.VOUT 0.75631f
C39 a_13178_981# VOUT 0
C40 MUX_2_1_2.tg_custom_6.VSN a_10276_1682# 0.06058f
C41 a_10276_2383# MUX_2_1_2.tg_custom_6.VSN 0.00585f
C42 a_10276_1682# MUX_2_1_1.inv_PI_0.VOUT 0
C43 MUX_2_1_1.tg_custom_2.VOUT MUX_2_1_1.inv_PI_1.VOUT 0.09498f
C44 a_10276_981# VDD 0.07502f
C45 VIND MUX_2_1_1.inv_PI_1.VOUT 0.1844f
C46 MUX_2_1_2.tg_custom_6.VOUT VS[0] 0.12982f
C47 MUX_2_1_2.tg_custom_6.VOUT VINB 0.00439f
C48 a_10276_2383# VINA 0
C49 MUX_2_1_0.tg_custom_6.VOUT a_13178_981# 0.01265f
C50 MUX_2_1_0.tg_custom_6.VOUT MUX_2_1_1.tg_custom_6.VSP 0
C51 VDD a_9268_875# -0
C52 MUX_2_1_0.VINA MUX_2_1_0.tg_custom_6.VSP 0
C53 MUX_2_1_1.tg_custom_2.VOUT MUX_2_1_1.tg_custom_6.VSP 0.2252f
C54 MUX_2_1_1.tg_custom_6.VSP VIND 0
C55 MUX_2_1_1.tg_custom_4.VSP VDD 0.55329f
C56 MUX_2_1_1.tg_custom_2.VOUT MUX_2_1_2.tg_custom_6.VSP 0.0057f
C57 MUX_2_1_2.tg_custom_2.VOUT MUX_2_1_2.tg_custom_6.VSP 0.22974f
C58 VDD a_12170_1576# -0
C59 MUX_2_1_2.tg_custom_6.VSN a_10802_2277# 0
C60 MUX_2_1_1.inv_PI_1.VOUT MUX_2_1_1.tg_custom_6.VOUT 0.72287f
C61 MUX_2_1_0.inv_PI_0.VOUT MUX_2_1_0.tg_custom_2.VOUT 0.75631f
C62 MUX_2_1_0.tg_custom_4.VSP MUX_2_1_0.tg_custom_6.VSP 0.03144f
C63 MUX_2_1_0.VINB VS[1] 0
C64 a_12994_1576# MUX_2_1_0.tg_custom_2.VOUT -0
C65 VS[1] MUX_2_1_2.tg_custom_4.VSP 0.039f
C66 MUX_2_1_0.VINA VS[0] 0
C67 MUX_2_1_0.tg_custom_6.VSP VDD 0.92546f
C68 MUX_2_1_2.tg_custom_6.VSN MUX_2_1_0.inv_PI_0.VOUT 0
C69 a_9680_2277# MUX_2_1_2.tg_custom_2.VOUT -0
C70 MUX_2_1_1.tg_custom_6.VSP MUX_2_1_1.tg_custom_6.VOUT 0.26465f
C71 VDD a_12170_875# -0
C72 a_10276_1682# VST 0
C73 MUX_2_1_0.VINB a_10276_280# 0
C74 VS[0] VDD 0.95444f
C75 MUX_2_1_0.inv_PI_0.VOUT a_13178_1682# 0.04339f
C76 VDD VINB 0.32454f
C77 MUX_2_1_2.tg_custom_6.VOUT MUX_2_1_1.tg_custom_2.VOUT 0.01974f
C78 MUX_2_1_0.tg_custom_4.VSP MUX_2_1_0.tg_custom_6.VSN 0.01511f
C79 MUX_2_1_2.tg_custom_6.VOUT MUX_2_1_2.tg_custom_2.VOUT 0.01974f
C80 MUX_2_1_0.VINB a_10802_875# -0
C81 a_10276_2383# MUX_2_1_2.inv_PI_0.VOUT 0.04339f
C82 MUX_2_1_0.tg_custom_6.VSN VDD 1.07222f
C83 a_13292_1576# MUX_2_1_0.tg_custom_6.VSP -0
C84 MUX_2_1_2.tg_custom_6.VSN MUX_2_1_0.VINB 0
C85 MUX_2_1_2.tg_custom_6.VSN VS[1] 0.01528f
C86 MUX_2_1_2.tg_custom_6.VSN MUX_2_1_2.tg_custom_4.VSP 0.01511f
C87 VS[0] MUX_2_1_2.inv_PI_1.VOUT 0.04803f
C88 MUX_2_1_2.inv_PI_1.VOUT VINB 0.1844f
C89 MUX_2_1_0.VINB MUX_2_1_1.tg_custom_6.VSN 0.25162f
C90 MUX_2_1_1.tg_custom_6.VSN VS[1] 0.02795f
C91 a_13704_1576# MUX_2_1_0.tg_custom_2.VOUT -0
C92 MUX_2_1_0.tg_custom_4.VSP VOUT 0.00102f
C93 MUX_2_1_0.VINB MUX_2_1_1.inv_PI_0.VOUT 0
C94 MUX_2_1_1.inv_PI_0.VOUT VS[1] 0.22058f
C95 MUX_2_1_1.inv_PI_0.VOUT MUX_2_1_2.tg_custom_4.VSP 0.00171f
C96 a_10390_2277# MUX_2_1_2.tg_custom_2.VOUT -0
C97 MUX_2_1_0.VINA MUX_2_1_1.tg_custom_2.VOUT 0.00849f
C98 MUX_2_1_0.inv_PI_0.VOUT VST 0.23883f
C99 VS[1] VINA 0
C100 VINA MUX_2_1_2.tg_custom_4.VSP 0.0755f
C101 VDD VOUT 0.13555f
C102 MUX_2_1_0.VINA MUX_2_1_2.tg_custom_2.VOUT 0.28725f
C103 a_10276_981# MUX_2_1_1.tg_custom_4.VSP 0.01973f
C104 a_10276_1682# MUX_2_1_1.tg_custom_6.VSP 0
C105 a_10276_1682# MUX_2_1_2.tg_custom_6.VSP 0.05112f
C106 MUX_2_1_2.tg_custom_6.VSN a_10276_280# 0
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
