Fundacion-Fulgor/IHP__CDR4176/CDR4176-main/schematic/xschem/6ph_rosc/6ph_rosc_pex.spice

* NGSPICE file created from 6ph_rosc.ext - technology: ihp-sg13g2

.subckt 6ph_rosc_pex CTRL PH0 PH3 PH2 PH5 PH4 PH1 VSS VDD
X0 psdiff_1.VOUTDP psdiff_1.buff_d8_0.inv_d8_0.VIN VDD.t14 VDD.t0 sg13_lv_pmos ad=55.5f pd=0.74u as=0.1005p ps=1.34u w=0.15u l=0.13u
X1 CTRL.t0 PH4.t10 CTRL.t0 VDD.t30 sg13_lv_pmos ad=0.19p pd=1.38u as=0 ps=0 w=1u l=0.13u
X2 VSS.t451 psdiff_0.buff_d8_1.inv_d8_0.VIN psdiff_2.CLKP.t6 VSS.t450 sg13_lv_nmos ad=0.1005p pd=1.34u as=55.5f ps=0.74u w=0.15u l=0.13u
X3 VDD.t2 psdiff_0.buff_d8_0.inv_d2_0.VIN psdiff_0.buff_d8_0.inv_d4_0.VIN VDD.t0 sg13_lv_pmos ad=0.1005p pd=1.34u as=55.5f ps=0.74u w=0.15u l=0.13u
X4 psdiff_2.buff_d8_1.VIN.t16 psdiff_2.CLKP.t8 VSS.t458 VSS.t468 sg13_lv_nmos ad=55.5f pd=0.74u as=55.5f ps=0.74u w=0.15u l=0.13u
X5 VSS.t364 psdiff_0.buff_d8_1.inv_d2_0.VIN psdiff_0.buff_d8_1.inv_d4_0.VIN VSS.t363 sg13_lv_nmos ad=0.1005p pd=1.34u as=55.5f ps=0.74u w=0.15u l=0.13u
X6 VSS.t407 psdiff_2.CLKN psdiff_2.buff_d8_0.VIN.t5 VSS.t373 sg13_lv_nmos ad=55.5f pd=0.74u as=55.5f ps=0.74u w=0.15u l=0.13u
X7 VDD.t156 buff_d8_2.inv_d8_0.VIN PH4.t5 VDD.t149 sg13_lv_pmos ad=0.1005p pd=1.34u as=55.5f ps=0.74u w=0.15u l=0.13u
X8 psdiff_2.VOUTDP psdiff_2.buff_d8_0.inv_d8_0.VIN VSS.t43 VSS.t42 sg13_lv_nmos ad=55.5f pd=0.74u as=0.1005p ps=1.34u w=0.15u l=0.13u
X9 CTRL.t16 PH5.t10 CTRL.t16 VDD.t38 sg13_lv_pmos ad=0.19p pd=1.38u as=0 ps=0 w=1u l=0.13u
X10 psdiff_0.buff_d8_1.inv_d8_0.VIN psdiff_0.buff_d8_1.inv_d4_0.VIN VSS.t372 VSS.t371 sg13_lv_nmos ad=55.5f pd=0.74u as=0.1005p ps=1.34u w=0.15u l=0.13u
X11 psdiff_0.buff_d8_0.VIN.t18 psdiff_1.VOUTDP VSS.t333 VSS.t151 sg13_lv_nmos ad=55.5f pd=0.74u as=55.5f ps=0.74u w=0.15u l=0.13u
X12 VSS.t109 psdiff_1.VOUTDN psdiff_0.buff_d8_1.VIN.t4 VSS.t112 sg13_lv_nmos ad=55.5f pd=0.74u as=55.5f ps=0.74u w=0.15u l=0.13u
X13 CTRL.t11 PH3.t10 CTRL.t11 VDD.t61 sg13_lv_pmos ad=0.19p pd=1.38u as=0 ps=0 w=1u l=0.13u
X14 CTRL.t22 PH2.t10 CTRL.t22 VDD.t41 sg13_lv_pmos ad=0.19p pd=1.38u as=0 ps=0 w=1u l=0.13u
X15 VDD.t74 psdiff_1.buff_d8_1.inv_d4_0.VIN psdiff_1.buff_d8_1.inv_d8_0.VIN VDD.t33 sg13_lv_pmos ad=0.1005p pd=1.34u as=55.5f ps=0.74u w=0.15u l=0.13u
X16 VDD.t286 VSS.t610 psdiff_2.buff_d8_1.VIN.t24 VDD.t169 sg13_lv_pmos ad=55.5f pd=0.74u as=55.5f ps=0.74u w=0.15u l=0.13u
X17 CTRL.t11 PH3.t10 CTRL.t11 VDD.t60 sg13_lv_pmos ad=0.19p pd=1.38u as=0 ps=0 w=1u l=0.13u
X18 psdiff_2.VOUTDN psdiff_2.buff_d8_1.inv_d8_0.VIN VDD.t90 VDD.t33 sg13_lv_pmos ad=55.5f pd=0.74u as=0.1005p ps=1.34u w=0.15u l=0.13u
X19 VDD.t297 VSS.t610 psdiff_2.buff_d8_0.VIN.t24 VDD.t169 sg13_lv_pmos ad=55.5f pd=0.74u as=55.5f ps=0.74u w=0.15u l=0.13u
X20 CTRL.t22 PH2.t10 CTRL.t22 VDD.t55 sg13_lv_pmos ad=0.19p pd=1.38u as=0 ps=0 w=1u l=0.13u
X21 VSS.t427 buff_d8_2.inv_d8_0.VIN PH4.t9 VSS.t426 sg13_lv_nmos ad=0.1005p pd=1.34u as=55.5f ps=0.74u w=0.15u l=0.13u
X22 VDD.t99 buff_d8_1.inv_d8_0.VIN PH5.t5 VDD.t23 sg13_lv_pmos ad=0.1005p pd=1.34u as=55.5f ps=0.74u w=0.15u l=0.13u
X23 VSS.t330 psdiff_1.VOUTDP psdiff_0.buff_d8_0.VIN.t11 VSS.t324 sg13_lv_nmos ad=55.5f pd=0.74u as=55.5f ps=0.74u w=0.15u l=0.13u
X24 psdiff_1.buff_d8_0.VIN.t11 psdiff_2.VOUTDP VSS.t82 VSS.t69 sg13_lv_nmos ad=55.5f pd=0.74u as=55.5f ps=0.74u w=0.15u l=0.13u
X25 VSS.t260 psdiff_2.VOUTDN psdiff_1.buff_d8_1.VIN.t7 VSS.t235 sg13_lv_nmos ad=55.5f pd=0.74u as=55.5f ps=0.74u w=0.15u l=0.13u
X26 VSS.t233 psdiff_2.buff_d8_1.inv_d8_0.VIN psdiff_2.VOUTDN VSS.t232 sg13_lv_nmos ad=0.1005p pd=1.34u as=55.5f ps=0.74u w=0.15u l=0.13u
X27 VDD.t173 a_1214_1266# psdiff_2.buff_d8_1.VIN.t31 VDD.t169 sg13_lv_pmos ad=55.5f pd=0.74u as=55.5f ps=0.74u w=0.15u l=0.13u
X28 psdiff_1.buff_d8_1.VIN.t26 VSS.t611 VDD.t343 VDD.t129 sg13_lv_pmos ad=55.5f pd=0.74u as=55.5f ps=0.74u w=0.15u l=0.13u
X29 VDD.t345 VSS.t611 psdiff_1.buff_d8_0.VIN.t31 VDD.t129 sg13_lv_pmos ad=55.5f pd=0.74u as=55.5f ps=0.74u w=0.15u l=0.13u
X30 psdiff_2.CLKN psdiff_0.buff_d8_0.inv_d8_0.VIN VSS.t505 VSS.t504 sg13_lv_nmos ad=55.5f pd=0.74u as=0.1005p ps=1.34u w=0.15u l=0.13u
X31 psdiff_1.VOUTDP psdiff_1.buff_d8_0.inv_d8_0.VIN VDD.t13 VDD.t0 sg13_lv_pmos ad=55.5f pd=0.74u as=0.1005p ps=1.34u w=0.15u l=0.13u
X32 VSS.t477 psdiff_2.CLKP.t8 psdiff_2.buff_d8_1.VIN.t14 VSS.t464 sg13_lv_nmos ad=55.5f pd=0.74u as=55.5f ps=0.74u w=0.15u l=0.13u
X33 CTRL.t3 PH4.t10 CTRL.t3 VDD.t149 sg13_lv_pmos ad=0.19p pd=1.38u as=0 ps=0 w=1u l=0.13u
X34 buff_d8_5.inv_d8_0.VIN buff_d8_5.inv_d4_0.VIN VSS.t513 VSS.t512 sg13_lv_nmos ad=55.5f pd=0.74u as=0.1005p ps=1.34u w=0.15u l=0.13u
X35 VSS.t75 psdiff_2.VOUTDP psdiff_1.buff_d8_0.VIN.t3 VSS.t44 sg13_lv_nmos ad=55.5f pd=0.74u as=55.5f ps=0.74u w=0.15u l=0.13u
X36 CTRL.t13 PH0.t10 CTRL.t13 VDD.t46 sg13_lv_pmos ad=0.19p pd=1.38u as=0 ps=0 w=1u l=0.13u
X37 CTRL.t7 PH4.t10 CTRL.t3 VDD.t149 sg13_lv_pmos ad=0.34p pd=2.68u as=0 ps=0 w=1u l=0.13u
X38 VDD.t54 psdiff_1.buff_d8_0.VIN.t32 psdiff_1.buff_d8_0.inv_d2_0.VIN VDD.t0 sg13_lv_pmos ad=0.1005p pd=1.34u as=0.1005p ps=1.34u w=0.15u l=0.13u
X39 VDD.t295 VSS.t610 psdiff_2.buff_d8_0.VIN.t26 VDD.t169 sg13_lv_pmos ad=55.5f pd=0.74u as=55.5f ps=0.74u w=0.15u l=0.13u
X40 buff_d8_3.inv_d8_0.VIN buff_d8_3.inv_d4_0.VIN VSS.t541 VSS.t540 sg13_lv_nmos ad=55.5f pd=0.74u as=0.1005p ps=1.34u w=0.15u l=0.13u
X41 psdiff_2.buff_d8_1.VIN.t15 psdiff_2.CLKP.t8 VSS.t470 VSS.t476 sg13_lv_nmos ad=55.5f pd=0.74u as=55.5f ps=0.74u w=0.15u l=0.13u
X42 VDD.t44 PH1.t10 PH4.t0 VDD.t43 sg13_lv_pmos ad=0.1005p pd=1.34u as=55.5f ps=0.74u w=0.15u l=0.13u
X43 VSS.t449 psdiff_0.buff_d8_1.inv_d8_0.VIN psdiff_2.CLKP.t7 VSS.t448 sg13_lv_nmos ad=0.1005p pd=1.34u as=55.5f ps=0.74u w=0.15u l=0.13u
X44 VDD.t296 VSS.t610 psdiff_2.buff_d8_0.VIN.t23 VDD.t169 sg13_lv_pmos ad=55.5f pd=0.74u as=55.5f ps=0.74u w=0.15u l=0.13u
X45 psdiff_0.buff_d8_1.VIN.t23 VSS.t612 VDD.t370 VDD.t108 sg13_lv_pmos ad=55.5f pd=0.74u as=55.5f ps=0.74u w=0.15u l=0.13u
X46 PH1.t9 buff_d8_3.inv_d8_0.VIN VSS.t557 VSS.t556 sg13_lv_nmos ad=55.5f pd=0.74u as=0.1005p ps=1.34u w=0.15u l=0.13u
X47 CTRL.t13 PH0.t10 CTRL.t13 VDD.t46 sg13_lv_pmos ad=0.19p pd=1.38u as=0 ps=0 w=1u l=0.13u
X48 CTRL.t9 PH3.t10 CTRL.t9 VDD.t61 sg13_lv_pmos ad=0.19p pd=1.38u as=0 ps=0 w=1u l=0.13u
X49 VDD.t107 buff_d8_4.inv_d8_0.VIN PH3.t4 VDD.t23 sg13_lv_pmos ad=0.1005p pd=1.34u as=55.5f ps=0.74u w=0.15u l=0.13u
X50 CTRL.t9 PH3.t10 CTRL.t9 VDD.t60 sg13_lv_pmos ad=0.19p pd=1.38u as=0 ps=0 w=1u l=0.13u
X51 VSS.t74 psdiff_2.VOUTDP psdiff_1.buff_d8_0.VIN.t1 VSS.t56 sg13_lv_nmos ad=55.5f pd=0.74u as=55.5f ps=0.74u w=0.15u l=0.13u
X52 VDD.t82 psdiff_1.buff_d8_1.inv_d8_0.VIN psdiff_1.VOUTDN VDD.t33 sg13_lv_pmos ad=0.1005p pd=1.34u as=55.5f ps=0.74u w=0.15u l=0.13u
X53 VSS.t358 psdiff_1.VOUTDP psdiff_0.buff_d8_0.VIN.t13 VSS.t347 sg13_lv_nmos ad=0.1005p pd=1.34u as=55.5f ps=0.74u w=0.15u l=0.13u
X54 psdiff_0.buff_d8_0.VIN.t17 psdiff_1.VOUTDP VSS.t328 VSS.t151 sg13_lv_nmos ad=55.5f pd=0.74u as=55.5f ps=0.74u w=0.15u l=0.13u
X55 psdiff_1.buff_d8_1.VIN.t16 psdiff_2.VOUTDN VSS.t241 VSS.t252 sg13_lv_nmos ad=55.5f pd=0.74u as=55.5f ps=0.74u w=0.15u l=0.13u
X56 VSS.t529 buff_d8_5.inv_d8_0.VIN PH0.t9 VSS.t528 sg13_lv_nmos ad=0.1005p pd=1.34u as=55.5f ps=0.74u w=0.15u l=0.13u
X57 VSS.t110 psdiff_1.VOUTDN psdiff_0.buff_d8_1.VIN.t2 VSS.t112 sg13_lv_nmos ad=55.5f pd=0.74u as=55.5f ps=0.74u w=0.15u l=0.13u
X58 VDD.t116 a_6005_1122# psdiff_0.buff_d8_0.VIN.t6 VDD.t108 sg13_lv_pmos ad=55.5f pd=0.74u as=55.5f ps=0.74u w=0.15u l=0.13u
X59 buff_d8_4.inv_d2_0.VIN psdiff_2.VOUTDP VSS.t79 VSS.t78 sg13_lv_nmos ad=0.1005p pd=1.34u as=0.1005p ps=1.34u w=0.15u l=0.13u
X60 psdiff_2.buff_d8_0.VIN.t16 psdiff_2.CLKN VSS.t378 VSS.t387 sg13_lv_nmos ad=55.5f pd=0.74u as=55.5f ps=0.74u w=0.15u l=0.13u
X61 VSS.t405 psdiff_2.CLKN psdiff_2.buff_d8_0.VIN.t3 VSS.t146 sg13_lv_nmos ad=55.5f pd=0.74u as=55.5f ps=0.74u w=0.15u l=0.13u
X62 psdiff_1.buff_d8_0.VIN.t10 psdiff_2.VOUTDP VSS.t77 VSS.t69 sg13_lv_nmos ad=55.5f pd=0.74u as=55.5f ps=0.74u w=0.15u l=0.13u
X63 buff_d8_5.inv_d4_0.VIN buff_d8_5.inv_d2_0.VIN VSS.t311 VSS.t310 sg13_lv_nmos ad=55.5f pd=0.74u as=0.1005p ps=1.34u w=0.15u l=0.13u
X64 PH4.t8 buff_d8_2.inv_d8_0.VIN VSS.t425 VSS.t424 sg13_lv_nmos ad=55.5f pd=0.74u as=0.1005p ps=1.34u w=0.15u l=0.13u
X65 psdiff_0.buff_d8_0.VIN.t25 VSS.t612 VDD.t371 VDD.t108 sg13_lv_pmos ad=55.5f pd=0.74u as=55.5f ps=0.74u w=0.15u l=0.13u
X66 PH5.t4 buff_d8_1.inv_d8_0.VIN VDD.t98 VDD.t23 sg13_lv_pmos ad=55.5f pd=0.74u as=0.1005p ps=1.34u w=0.15u l=0.13u
X67 CTRL.t2 PH4.t10 CTRL.t2 VDD.t149 sg13_lv_pmos ad=0.19p pd=1.38u as=0 ps=0 w=1u l=0.13u
X68 buff_d8_1.inv_d4_0.VIN buff_d8_1.inv_d2_0.VIN VDD.t124 VDD.t23 sg13_lv_pmos ad=55.5f pd=0.74u as=0.1005p ps=1.34u w=0.15u l=0.13u
X69 psdiff_0.buff_d8_0.VIN.t31 VSS.t612 VDD.t391 VDD.t108 sg13_lv_pmos ad=55.5f pd=0.74u as=0.1005p ps=1.34u w=0.15u l=0.13u
X70 VDD.t131 a_3031_1122# psdiff_1.buff_d8_0.VIN.t19 VDD.t129 sg13_lv_pmos ad=55.5f pd=0.74u as=55.5f ps=0.74u w=0.15u l=0.13u
X71 CTRL.t11 PH0.t10 CTRL.t11 VDD.t46 sg13_lv_pmos ad=0.19p pd=1.38u as=0 ps=0 w=1u l=0.13u
X72 psdiff_0.buff_d8_0.VIN.t23 VSS.t612 VDD.t369 VDD.t108 sg13_lv_pmos ad=55.5f pd=0.74u as=55.5f ps=0.74u w=0.15u l=0.13u
X73 CTRL.t6 PH4.t10 CTRL.t2 VDD.t149 sg13_lv_pmos ad=0.34p pd=2.68u as=0 ps=0 w=1u l=0.13u
X74 VSS.t565 psdiff_2.buff_d8_1.inv_d4_0.VIN psdiff_2.buff_d8_1.inv_d8_0.VIN VSS.t564 sg13_lv_nmos ad=0.1005p pd=1.34u as=55.5f ps=0.74u w=0.15u l=0.13u
X75 VSS.t323 buff_d8_1.inv_d4_0.VIN buff_d8_1.inv_d8_0.VIN VSS.t322 sg13_lv_nmos ad=0.1005p pd=1.34u as=55.5f ps=0.74u w=0.15u l=0.13u
X76 buff_d8_4.inv_d4_0.VIN buff_d8_4.inv_d2_0.VIN VSS.t307 VSS.t306 sg13_lv_nmos ad=55.5f pd=0.74u as=0.1005p ps=1.34u w=0.15u l=0.13u
X77 VSS.t145 PH4.t11 PH1.t1 VSS.t144 sg13_lv_nmos ad=0.1005p pd=1.34u as=55.5f ps=0.74u w=0.15u l=0.13u
X78 psdiff_2.buff_d8_1.VIN.t13 psdiff_2.CLKP.t8 VSS.t465 VSS.t476 sg13_lv_nmos ad=55.5f pd=0.74u as=55.5f ps=0.74u w=0.15u l=0.13u
X79 PH0.t5 buff_d8_5.inv_d8_0.VIN VDD.t200 VDD.t46 sg13_lv_pmos ad=55.5f pd=0.74u as=0.1005p ps=1.34u w=0.15u l=0.13u
X80 VSS.t353 psdiff_1.VOUTDP psdiff_0.buff_d8_0.VIN.t8 VSS.t338 sg13_lv_nmos ad=55.5f pd=0.74u as=55.5f ps=0.74u w=0.15u l=0.13u
X81 VSS.t266 psdiff_2.VOUTDN psdiff_1.buff_d8_1.VIN.t4 VSS.t251 sg13_lv_nmos ad=55.5f pd=0.74u as=55.5f ps=0.74u w=0.15u l=0.13u
X82 psdiff_2.buff_d8_1.VIN.t26 VSS.t610 VDD.t301 VDD.t169 sg13_lv_pmos ad=55.5f pd=0.74u as=55.5f ps=0.74u w=0.15u l=0.13u
X83 psdiff_0.buff_d8_1.VIN.t0 psdiff_1.VOUTDN VSS.t90 VSS.t96 sg13_lv_nmos ad=55.5f pd=0.74u as=55.5f ps=0.74u w=0.15u l=0.13u
X84 CTRL.t11 PH0.t10 CTRL.t11 VDD.t46 sg13_lv_pmos ad=0.19p pd=1.38u as=0 ps=0 w=1u l=0.13u
X85 psdiff_1.buff_d8_1.VIN.t1 CTRL.t24 a_3031_1122# VSS.t153 sg13_lv_nmos ad=0.1005p pd=1.34u as=55.5f ps=0.74u w=0.15u l=0.13u
X86 PH1.t8 buff_d8_3.inv_d8_0.VIN VSS.t555 VSS.t554 sg13_lv_nmos ad=55.5f pd=0.74u as=0.1005p ps=1.34u w=0.15u l=0.13u
X87 VDD.t187 psdiff_0.buff_d8_0.inv_d8_0.VIN psdiff_2.CLKN VDD.t0 sg13_lv_pmos ad=0.1005p pd=1.34u as=55.5f ps=0.74u w=0.15u l=0.13u
X88 psdiff_1.VOUTDP psdiff_1.buff_d8_0.inv_d8_0.VIN VSS.t27 VSS.t26 sg13_lv_nmos ad=55.5f pd=0.74u as=0.1005p ps=1.34u w=0.15u l=0.13u
X89 CTRL.t22 PH5.t10 CTRL.t22 VDD.t36 sg13_lv_pmos ad=0.19p pd=1.38u as=0 ps=0 w=1u l=0.13u
X90 VDD.t230 buff_d8_0.inv_d8_0.VIN PH2.t4 VDD.t41 sg13_lv_pmos ad=0.1005p pd=1.34u as=55.5f ps=0.74u w=0.15u l=0.13u
X91 psdiff_2.buff_d8_0.VIN.t15 psdiff_2.CLKN VSS.t374 VSS.t396 sg13_lv_nmos ad=55.5f pd=0.74u as=55.5f ps=0.74u w=0.15u l=0.13u
X92 PH0.t1 PH3.t11 VSS.t177 VSS.t176 sg13_lv_nmos ad=55.5f pd=0.74u as=0.1005p ps=1.34u w=0.15u l=0.13u
X93 VDD.t106 buff_d8_4.inv_d8_0.VIN PH3.t5 VDD.t23 sg13_lv_pmos ad=0.1005p pd=1.34u as=55.5f ps=0.74u w=0.15u l=0.13u
X94 VDD.t57 PH2.t11 PH5.t0 VDD.t56 sg13_lv_pmos ad=0.1005p pd=1.34u as=55.5f ps=0.74u w=0.15u l=0.13u
X95 CTRL.t22 PH5.t10 CTRL.t22 VDD.t38 sg13_lv_pmos ad=0.19p pd=1.38u as=0 ps=0 w=1u l=0.13u
X96 PH4.t4 buff_d8_2.inv_d8_0.VIN VDD.t155 VDD.t61 sg13_lv_pmos ad=55.5f pd=0.74u as=0.1005p ps=1.34u w=0.15u l=0.13u
X97 psdiff_2.buff_d8_1.inv_d8_0.VIN psdiff_2.buff_d8_1.inv_d4_0.VIN VDD.t218 VDD.t33 sg13_lv_pmos ad=55.5f pd=0.74u as=0.1005p ps=1.34u w=0.15u l=0.13u
X98 VDD.t351 VSS.t611 psdiff_1.buff_d8_1.VIN.t24 VDD.t129 sg13_lv_pmos ad=0.1005p pd=1.34u as=55.5f ps=0.74u w=0.15u l=0.13u
X99 VSS.t355 psdiff_1.VOUTDP psdiff_0.buff_d8_0.VIN.t10 VSS.t347 sg13_lv_nmos ad=0.1005p pd=1.34u as=55.5f ps=0.74u w=0.15u l=0.13u
X100 CTRL.t22 PH5.t10 CTRL.t22 VDD.t41 sg13_lv_pmos ad=0.19p pd=1.38u as=0 ps=0 w=1u l=0.13u
X101 CTRL.t3 PH1.t11 CTRL.t3 VDD.t27 sg13_lv_pmos ad=0.19p pd=1.38u as=0 ps=0 w=1u l=0.13u
X102 CTRL.t1 PH4.t10 CTRL.t1 VDD.t149 sg13_lv_pmos ad=0.19p pd=1.38u as=0 ps=0 w=1u l=0.13u
X103 VDD.t146 psdiff_0.buff_d8_1.inv_d4_0.VIN psdiff_0.buff_d8_1.inv_d8_0.VIN VDD.t33 sg13_lv_pmos ad=0.1005p pd=1.34u as=55.5f ps=0.74u w=0.15u l=0.13u
X104 psdiff_0.buff_d8_1.inv_d2_0.VIN psdiff_0.buff_d8_1.VIN.t32 VDD.t59 VDD.t33 sg13_lv_pmos ad=0.1005p pd=1.34u as=0.1005p ps=1.34u w=0.15u l=0.13u
X105 CTRL.t9 PH0.t10 CTRL.t9 VDD.t46 sg13_lv_pmos ad=0.19p pd=1.38u as=0 ps=0 w=1u l=0.13u
X106 CTRL.t5 PH4.t10 CTRL.t1 VDD.t149 sg13_lv_pmos ad=0.34p pd=2.68u as=0 ps=0 w=1u l=0.13u
X107 psdiff_1.buff_d8_0.VIN.t25 VSS.t611 VDD.t336 VDD.t129 sg13_lv_pmos ad=55.5f pd=0.74u as=55.5f ps=0.74u w=0.15u l=0.13u
X108 CTRL.t3 PH1.t11 CTRL.t3 VDD.t30 sg13_lv_pmos ad=0.19p pd=1.38u as=0 ps=0 w=1u l=0.13u
X109 psdiff_1.buff_d8_1.VIN.t31 a_4188_1266# VDD.t238 VDD.t129 sg13_lv_pmos ad=55.5f pd=0.74u as=55.5f ps=0.74u w=0.15u l=0.13u
X110 VDD.t359 VSS.t612 psdiff_0.buff_d8_1.VIN.t26 VDD.t108 sg13_lv_pmos ad=55.5f pd=0.74u as=55.5f ps=0.74u w=0.15u l=0.13u
X111 psdiff_0.buff_d8_0.VIN.t21 psdiff_1.VOUTDP VSS.t84 VSS.t337 sg13_lv_nmos ad=55.5f pd=0.74u as=55.5f ps=0.74u w=0.15u l=0.13u
X112 VDD.t222 buff_d8_4.inv_d4_0.VIN buff_d8_4.inv_d8_0.VIN VDD.t23 sg13_lv_pmos ad=0.1005p pd=1.34u as=55.5f ps=0.74u w=0.15u l=0.13u
X113 VSS.t115 psdiff_1.VOUTDN psdiff_0.buff_d8_1.VIN.t1 VSS.t95 sg13_lv_nmos ad=55.5f pd=0.74u as=55.5f ps=0.74u w=0.15u l=0.13u
X114 CTRL.t9 PH0.t10 CTRL.t9 VDD.t46 sg13_lv_pmos ad=0.19p pd=1.38u as=0 ps=0 w=1u l=0.13u
X115 VSS.t287 buff_d8_1.inv_d8_0.VIN PH5.t8 VSS.t286 sg13_lv_nmos ad=0.1005p pd=1.34u as=55.5f ps=0.74u w=0.15u l=0.13u
X116 VSS.t503 psdiff_0.buff_d8_0.inv_d8_0.VIN psdiff_2.CLKN VSS.t502 sg13_lv_nmos ad=0.1005p pd=1.34u as=55.5f ps=0.74u w=0.15u l=0.13u
X117 psdiff_1.buff_d8_0.VIN.t14 psdiff_2.VOUTDP VSS.t45 VSS.t63 sg13_lv_nmos ad=55.5f pd=0.74u as=55.5f ps=0.74u w=0.15u l=0.13u
X118 VDD.t322 VSS.t611 psdiff_1.buff_d8_1.VIN.t22 VDD.t129 sg13_lv_pmos ad=55.5f pd=0.74u as=55.5f ps=0.74u w=0.15u l=0.13u
X119 psdiff_2.buff_d8_1.VIN.t29 a_1214_1266# VDD.t178 VDD.t169 sg13_lv_pmos ad=55.5f pd=0.74u as=55.5f ps=0.74u w=0.15u l=0.13u
X120 VDD.t331 VSS.t611 psdiff_1.buff_d8_1.VIN.t23 VDD.t129 sg13_lv_pmos ad=55.5f pd=0.74u as=55.5f ps=0.74u w=0.15u l=0.13u
X121 PH5.t9 buff_d8_1.inv_d8_0.VIN VSS.t285 VSS.t284 sg13_lv_nmos ad=55.5f pd=0.74u as=0.1005p ps=1.34u w=0.15u l=0.13u
X122 psdiff_1.buff_d8_0.inv_d4_0.VIN psdiff_1.buff_d8_0.inv_d2_0.VIN VSS.t533 VSS.t532 sg13_lv_nmos ad=55.5f pd=0.74u as=0.1005p ps=1.34u w=0.15u l=0.13u
X123 VSS.t481 psdiff_2.CLKP.t8 psdiff_2.buff_d8_1.VIN.t16 VSS.t152 sg13_lv_nmos ad=55.5f pd=0.74u as=55.5f ps=0.74u w=0.15u l=0.13u
X124 VDD.t214 buff_d8_3.inv_d8_0.VIN PH1.t5 VDD.t23 sg13_lv_pmos ad=0.1005p pd=1.34u as=55.5f ps=0.74u w=0.15u l=0.13u
X125 psdiff_2.buff_d8_0.VIN.t14 psdiff_2.CLKN VSS.t407 VSS.t396 sg13_lv_nmos ad=55.5f pd=0.74u as=55.5f ps=0.74u w=0.15u l=0.13u
X126 CTRL.t8 PH3.t10 CTRL.t8 VDD.t61 sg13_lv_pmos ad=0.19p pd=1.38u as=0 ps=0 w=1u l=0.13u
X127 CTRL.t8 PH3.t10 CTRL.t8 VDD.t60 sg13_lv_pmos ad=0.19p pd=1.38u as=0 ps=0 w=1u l=0.13u
X128 psdiff_1.buff_d8_0.inv_d4_0.VIN psdiff_1.buff_d8_0.inv_d2_0.VIN VDD.t202 VDD.t0 sg13_lv_pmos ad=55.5f pd=0.74u as=0.1005p ps=1.34u w=0.15u l=0.13u
X129 VSS.t605 psdiff_2.buff_d8_0.inv_d4_0.VIN psdiff_2.buff_d8_0.inv_d8_0.VIN VSS.t604 sg13_lv_nmos ad=0.1005p pd=1.34u as=55.5f ps=0.74u w=0.15u l=0.13u
X130 CTRL.t2 PH1.t11 CTRL.t2 VDD.t27 sg13_lv_pmos ad=0.19p pd=1.38u as=0 ps=0 w=1u l=0.13u
X131 VDD.t362 VSS.t612 psdiff_0.buff_d8_0.VIN.t27 VDD.t108 sg13_lv_pmos ad=55.5f pd=0.74u as=55.5f ps=0.74u w=0.15u l=0.13u
X132 CTRL.t8 PH3.t10 CTRL.t8 VDD.t47 sg13_lv_pmos ad=0.19p pd=1.38u as=0 ps=0 w=1u l=0.13u
X133 CTRL.t2 PH1.t11 CTRL.t2 VDD.t30 sg13_lv_pmos ad=0.19p pd=1.38u as=0 ps=0 w=1u l=0.13u
X134 VDD.t117 a_6005_1122# psdiff_0.buff_d8_0.VIN.t5 VDD.t108 sg13_lv_pmos ad=55.5f pd=0.74u as=55.5f ps=0.74u w=0.15u l=0.13u
X135 CTRL.t20 PH2.t10 CTRL.t20 VDD.t55 sg13_lv_pmos ad=0.19p pd=1.38u as=0 ps=0 w=1u l=0.13u
X136 psdiff_2.buff_d8_0.VIN.t28 a_57_1122# VDD.t251 VDD.t169 sg13_lv_pmos ad=55.5f pd=0.74u as=55.5f ps=0.74u w=0.15u l=0.13u
X137 VSS.t117 psdiff_1.VOUTDN buff_d8_2.inv_d2_0.VIN VSS.t116 sg13_lv_nmos ad=0.1005p pd=1.34u as=0.1005p ps=1.34u w=0.15u l=0.13u
X138 psdiff_2.buff_d8_0.VIN.t31 a_57_1122# VDD.t252 VDD.t169 sg13_lv_pmos ad=55.5f pd=0.74u as=55.5f ps=0.74u w=0.15u l=0.13u
X139 VDD.t265 a_7162_1266# psdiff_0.buff_d8_1.VIN.t27 VDD.t108 sg13_lv_pmos ad=55.5f pd=0.74u as=55.5f ps=0.74u w=0.15u l=0.13u
X140 buff_d8_2.inv_d8_0.VIN buff_d8_2.inv_d4_0.VIN VSS.t129 VSS.t128 sg13_lv_nmos ad=55.5f pd=0.74u as=0.1005p ps=1.34u w=0.15u l=0.13u
X141 VDD.t291 VSS.t610 psdiff_2.buff_d8_1.VIN.t23 VDD.t169 sg13_lv_pmos ad=55.5f pd=0.74u as=55.5f ps=0.74u w=0.15u l=0.13u
X142 PH3.t1 PH0.t11 VSS.t159 VSS.t158 sg13_lv_nmos ad=55.5f pd=0.74u as=0.1005p ps=1.34u w=0.15u l=0.13u
X143 VSS.t589 buff_d8_0.inv_d8_0.VIN PH2.t6 VSS.t588 sg13_lv_nmos ad=0.1005p pd=1.34u as=55.5f ps=0.74u w=0.15u l=0.13u
X144 psdiff_1.buff_d8_1.inv_d8_0.VIN psdiff_1.buff_d8_1.inv_d4_0.VIN VSS.t201 VSS.t200 sg13_lv_nmos ad=55.5f pd=0.74u as=0.1005p ps=1.34u w=0.15u l=0.13u
X145 VSS.t133 psdiff_1.buff_d8_1.inv_d2_0.VIN psdiff_1.buff_d8_1.inv_d4_0.VIN VSS.t132 sg13_lv_nmos ad=0.1005p pd=1.34u as=55.5f ps=0.74u w=0.15u l=0.13u
X146 VDD.t177 a_1214_1266# psdiff_2.buff_d8_1.VIN.t30 VDD.t169 sg13_lv_pmos ad=0.1005p pd=1.34u as=55.5f ps=0.74u w=0.15u l=0.13u
X147 VSS.t283 buff_d8_1.inv_d8_0.VIN PH5.t9 VSS.t282 sg13_lv_nmos ad=0.1005p pd=1.34u as=55.5f ps=0.74u w=0.15u l=0.13u
X148 psdiff_1.buff_d8_0.VIN.t13 psdiff_2.VOUTDP VSS.t75 VSS.t63 sg13_lv_nmos ad=55.5f pd=0.74u as=55.5f ps=0.74u w=0.15u l=0.13u
X149 a_57_1122# CTRL.t25 psdiff_2.buff_d8_1.VIN.t1 VSS.t152 sg13_lv_nmos ad=55.5f pd=0.74u as=0.1005p ps=1.34u w=0.15u l=0.13u
X150 VDD.t120 buff_d8_4.inv_d2_0.VIN buff_d8_4.inv_d4_0.VIN VDD.t23 sg13_lv_pmos ad=0.1005p pd=1.34u as=55.5f ps=0.74u w=0.15u l=0.13u
X151 CTRL.t0 PH4.t10 CTRL.t0 VDD.t30 sg13_lv_pmos ad=0.19p pd=1.38u as=0 ps=0 w=1u l=0.13u
X152 VDD.t12 psdiff_1.buff_d8_0.inv_d8_0.VIN psdiff_1.VOUTDP VDD.t0 sg13_lv_pmos ad=0.1005p pd=1.34u as=55.5f ps=0.74u w=0.15u l=0.13u
X153 CTRL.t1 PH1.t11 CTRL.t1 VDD.t27 sg13_lv_pmos ad=0.19p pd=1.38u as=0 ps=0 w=1u l=0.13u
X154 VSS.t181 psdiff_0.buff_d8_0.VIN.t32 psdiff_0.buff_d8_0.inv_d2_0.VIN VSS.t180 sg13_lv_nmos ad=0.1005p pd=1.34u as=0.1005p ps=1.34u w=0.15u l=0.13u
X155 VDD.t213 buff_d8_3.inv_d8_0.VIN PH1.t4 VDD.t23 sg13_lv_pmos ad=0.1005p pd=1.34u as=55.5f ps=0.74u w=0.15u l=0.13u
X156 PH1.t2 buff_d8_3.inv_d8_0.VIN VDD.t212 VDD.t23 sg13_lv_pmos ad=55.5f pd=0.74u as=0.1005p ps=1.34u w=0.15u l=0.13u
X157 CTRL.t1 PH1.t11 CTRL.t1 VDD.t30 sg13_lv_pmos ad=0.19p pd=1.38u as=0 ps=0 w=1u l=0.13u
X158 psdiff_2.buff_d8_1.VIN.t20 VSS.t610 VDD.t285 VDD.t169 sg13_lv_pmos ad=55.5f pd=0.74u as=55.5f ps=0.74u w=0.15u l=0.13u
X159 psdiff_0.buff_d8_1.VIN.t24 VSS.t612 VDD.t378 VDD.t108 sg13_lv_pmos ad=55.5f pd=0.74u as=55.5f ps=0.74u w=0.15u l=0.13u
X160 psdiff_1.buff_d8_0.VIN.t16 CTRL.t24 a_4188_1266# VSS.t46 sg13_lv_nmos ad=0.1005p pd=1.34u as=55.5f ps=0.74u w=0.15u l=0.13u
X161 VDD.t289 VSS.t610 psdiff_2.buff_d8_0.VIN.t25 VDD.t169 sg13_lv_pmos ad=55.5f pd=0.74u as=55.5f ps=0.74u w=0.15u l=0.13u
X162 psdiff_1.VOUTDP psdiff_1.buff_d8_0.inv_d8_0.VIN VSS.t25 VSS.t24 sg13_lv_nmos ad=55.5f pd=0.74u as=0.1005p ps=1.34u w=0.15u l=0.13u
X163 VSS.t41 psdiff_2.buff_d8_0.inv_d8_0.VIN psdiff_2.VOUTDP VSS.t40 sg13_lv_nmos ad=0.1005p pd=1.34u as=55.5f ps=0.74u w=0.15u l=0.13u
X164 psdiff_0.buff_d8_1.VIN.t30 a_7162_1266# VDD.t266 VDD.t108 sg13_lv_pmos ad=55.5f pd=0.74u as=55.5f ps=0.74u w=0.15u l=0.13u
X165 CTRL.t0 PH4.t10 CTRL.t0 VDD.t149 sg13_lv_pmos ad=0.19p pd=1.38u as=0 ps=0 w=1u l=0.13u
X166 VSS.t406 psdiff_2.CLKN psdiff_2.buff_d8_0.VIN.t16 VSS.t380 sg13_lv_nmos ad=0.1005p pd=1.34u as=55.5f ps=0.74u w=0.15u l=0.13u
X167 CTRL.t18 PH2.t10 CTRL.t18 VDD.t55 sg13_lv_pmos ad=0.19p pd=1.38u as=0 ps=0 w=1u l=0.13u
X168 psdiff_2.buff_d8_0.VIN.t13 psdiff_2.CLKN VSS.t405 VSS.t149 sg13_lv_nmos ad=55.5f pd=0.74u as=55.5f ps=0.74u w=0.15u l=0.13u
X169 CTRL.t8 PH0.t10 CTRL.t8 VDD.t46 sg13_lv_pmos ad=0.19p pd=1.38u as=0 ps=0 w=1u l=0.13u
X170 VSS.t141 buff_d8_0.inv_d4_0.VIN buff_d8_0.inv_d8_0.VIN VSS.t140 sg13_lv_nmos ad=0.1005p pd=1.34u as=55.5f ps=0.74u w=0.15u l=0.13u
X171 PH3.t8 buff_d8_4.inv_d8_0.VIN VSS.t303 VSS.t302 sg13_lv_nmos ad=55.5f pd=0.74u as=0.1005p ps=1.34u w=0.15u l=0.13u
X172 psdiff_1.buff_d8_1.VIN.t17 VSS.t611 VDD.t324 VDD.t129 sg13_lv_pmos ad=55.5f pd=0.74u as=55.5f ps=0.74u w=0.15u l=0.13u
X173 VDD.t191 buff_d8_5.inv_d4_0.VIN buff_d8_5.inv_d8_0.VIN VDD.t60 sg13_lv_pmos ad=0.1005p pd=1.34u as=55.5f ps=0.74u w=0.15u l=0.13u
X174 CTRL.t20 PH5.t10 CTRL.t20 VDD.t36 sg13_lv_pmos ad=0.19p pd=1.38u as=0 ps=0 w=1u l=0.13u
X175 VDD.t11 psdiff_1.buff_d8_0.inv_d8_0.VIN psdiff_1.VOUTDP VDD.t0 sg13_lv_pmos ad=0.1005p pd=1.34u as=55.5f ps=0.74u w=0.15u l=0.13u
X176 VDD.t63 PH3.t12 PH0.t0 VDD.t48 sg13_lv_pmos ad=0.1005p pd=1.34u as=55.5f ps=0.74u w=0.15u l=0.13u
X177 VDD.t199 buff_d8_5.inv_d8_0.VIN PH0.t3 VDD.t192 sg13_lv_pmos ad=0.1005p pd=1.34u as=55.5f ps=0.74u w=0.15u l=0.13u
X178 PH2.t9 buff_d8_0.inv_d8_0.VIN VSS.t587 VSS.t586 sg13_lv_nmos ad=55.5f pd=0.74u as=0.1005p ps=1.34u w=0.15u l=0.13u
X179 VSS.t217 psdiff_1.buff_d8_1.inv_d8_0.VIN psdiff_1.VOUTDN VSS.t216 sg13_lv_nmos ad=0.1005p pd=1.34u as=55.5f ps=0.74u w=0.15u l=0.13u
X180 CTRL.t15 PH0.t10 CTRL.t8 VDD.t46 sg13_lv_pmos ad=0.34p pd=2.68u as=0 ps=0 w=1u l=0.13u
X181 psdiff_1.VOUTDN psdiff_1.buff_d8_1.inv_d8_0.VIN VSS.t215 VSS.t214 sg13_lv_nmos ad=55.5f pd=0.74u as=0.1005p ps=1.34u w=0.15u l=0.13u
X182 VDD.t133 a_3031_1122# psdiff_1.buff_d8_0.VIN.t21 VDD.t129 sg13_lv_pmos ad=55.5f pd=0.74u as=55.5f ps=0.74u w=0.15u l=0.13u
X183 VSS.t480 psdiff_2.CLKP.t8 psdiff_2.buff_d8_1.VIN.t15 VSS.t472 sg13_lv_nmos ad=55.5f pd=0.74u as=55.5f ps=0.74u w=0.15u l=0.13u
X184 VDD.t89 psdiff_2.buff_d8_1.inv_d8_0.VIN psdiff_2.VOUTDN VDD.t33 sg13_lv_pmos ad=0.1005p pd=1.34u as=55.5f ps=0.74u w=0.15u l=0.13u
X185 psdiff_0.buff_d8_0.VIN.t29 VSS.t612 VDD.t376 VDD.t108 sg13_lv_pmos ad=55.5f pd=0.74u as=55.5f ps=0.74u w=0.15u l=0.13u
X186 PH4.t1 PH1.t12 VSS.t157 VSS.t156 sg13_lv_nmos ad=55.5f pd=0.74u as=0.1005p ps=1.34u w=0.15u l=0.13u
X187 psdiff_0.buff_d8_0.inv_d8_0.VIN psdiff_0.buff_d8_0.inv_d4_0.VIN VSS.t11 VSS.t10 sg13_lv_nmos ad=55.5f pd=0.74u as=0.1005p ps=1.34u w=0.15u l=0.13u
X188 VSS.t511 buff_d8_5.inv_d4_0.VIN buff_d8_5.inv_d8_0.VIN VSS.t510 sg13_lv_nmos ad=0.1005p pd=1.34u as=55.5f ps=0.74u w=0.15u l=0.13u
X189 VDD.t272 psdiff_2.CLKP.t9 buff_d8_0.inv_d2_0.VIN VDD.t36 sg13_lv_pmos ad=0.1005p pd=1.34u as=0.1005p ps=1.34u w=0.15u l=0.13u
X190 VSS.t169 psdiff_1.buff_d8_0.VIN.t32 psdiff_1.buff_d8_0.inv_d2_0.VIN VSS.t168 sg13_lv_nmos ad=0.1005p pd=1.34u as=0.1005p ps=1.34u w=0.15u l=0.13u
X191 CTRL.t16 PH2.t10 CTRL.t16 VDD.t55 sg13_lv_pmos ad=0.19p pd=1.38u as=0 ps=0 w=1u l=0.13u
X192 buff_d8_0.inv_d8_0.VIN buff_d8_0.inv_d4_0.VIN VDD.t42 VDD.t41 sg13_lv_pmos ad=55.5f pd=0.74u as=0.1005p ps=1.34u w=0.15u l=0.13u
X193 CTRL.t20 PH5.t10 CTRL.t20 VDD.t38 sg13_lv_pmos ad=0.19p pd=1.38u as=0 ps=0 w=1u l=0.13u
X194 psdiff_1.buff_d8_0.VIN.t24 VSS.t611 VDD.t346 VDD.t129 sg13_lv_pmos ad=55.5f pd=0.74u as=0.1005p ps=1.34u w=0.15u l=0.13u
X195 buff_d8_3.inv_d4_0.VIN buff_d8_3.inv_d2_0.VIN VDD.t160 VDD.t23 sg13_lv_pmos ad=55.5f pd=0.74u as=0.1005p ps=1.34u w=0.15u l=0.13u
X196 psdiff_1.buff_d8_0.VIN.t12 psdiff_2.VOUTDP VSS.t74 VSS.t50 sg13_lv_nmos ad=55.5f pd=0.74u as=55.5f ps=0.74u w=0.15u l=0.13u
X197 PH2.t0 PH5.t11 VDD.t65 VDD.t56 sg13_lv_pmos ad=55.5f pd=0.74u as=0.1005p ps=1.34u w=0.15u l=0.13u
X198 VSS.t263 psdiff_2.VOUTDN psdiff_1.buff_d8_1.VIN.t16 VSS.t150 sg13_lv_nmos ad=55.5f pd=0.74u as=55.5f ps=0.74u w=0.15u l=0.13u
X199 CTRL.t20 PH2.t10 CTRL.t20 VDD.t41 sg13_lv_pmos ad=0.19p pd=1.38u as=0 ps=0 w=1u l=0.13u
X200 psdiff_1.buff_d8_0.VIN.t29 VSS.t611 VDD.t345 VDD.t129 sg13_lv_pmos ad=55.5f pd=0.74u as=55.5f ps=0.74u w=0.15u l=0.13u
X201 psdiff_2.CLKP.t3 psdiff_0.buff_d8_1.inv_d8_0.VIN VDD.t168 VDD.t33 sg13_lv_pmos ad=55.5f pd=0.74u as=0.1005p ps=1.34u w=0.15u l=0.13u
X202 psdiff_0.buff_d8_1.inv_d4_0.VIN psdiff_0.buff_d8_1.inv_d2_0.VIN VDD.t142 VDD.t33 sg13_lv_pmos ad=55.5f pd=0.74u as=0.1005p ps=1.34u w=0.15u l=0.13u
X203 VSS.t431 buff_d8_0.inv_d2_0.VIN buff_d8_0.inv_d4_0.VIN VSS.t430 sg13_lv_nmos ad=0.1005p pd=1.34u as=55.5f ps=0.74u w=0.15u l=0.13u
X204 VSS.t370 psdiff_0.buff_d8_1.inv_d4_0.VIN psdiff_0.buff_d8_1.inv_d8_0.VIN VSS.t369 sg13_lv_nmos ad=0.1005p pd=1.34u as=55.5f ps=0.74u w=0.15u l=0.13u
X205 PH3.t7 buff_d8_4.inv_d8_0.VIN VSS.t301 VSS.t300 sg13_lv_nmos ad=55.5f pd=0.74u as=0.1005p ps=1.34u w=0.15u l=0.13u
X206 VSS.t539 buff_d8_3.inv_d4_0.VIN buff_d8_3.inv_d8_0.VIN VSS.t538 sg13_lv_nmos ad=0.1005p pd=1.34u as=55.5f ps=0.74u w=0.15u l=0.13u
X207 CTRL.t0 PH1.t11 CTRL.t0 VDD.t25 sg13_lv_pmos ad=0.19p pd=1.38u as=0 ps=0 w=1u l=0.13u
X208 psdiff_2.buff_d8_1.inv_d4_0.VIN psdiff_2.buff_d8_1.inv_d2_0.VIN VSS.t167 VSS.t166 sg13_lv_nmos ad=55.5f pd=0.74u as=0.1005p ps=1.34u w=0.15u l=0.13u
X209 CTRL.t18 PH5.t10 CTRL.t18 VDD.t36 sg13_lv_pmos ad=0.19p pd=1.38u as=0 ps=0 w=1u l=0.13u
X210 VSS.t447 psdiff_0.buff_d8_1.inv_d8_0.VIN psdiff_2.CLKP.t5 VSS.t446 sg13_lv_nmos ad=0.1005p pd=1.34u as=55.5f ps=0.74u w=0.15u l=0.13u
X211 CTRL.t13 PH3.t10 CTRL.t13 VDD.t60 sg13_lv_pmos ad=0.19p pd=1.38u as=0 ps=0 w=1u l=0.13u
X212 psdiff_1.VOUTDN psdiff_1.buff_d8_1.inv_d8_0.VIN VSS.t213 VSS.t212 sg13_lv_nmos ad=55.5f pd=0.74u as=0.1005p ps=1.34u w=0.15u l=0.13u
X213 psdiff_0.buff_d8_0.inv_d8_0.VIN psdiff_0.buff_d8_0.inv_d4_0.VIN VDD.t6 VDD.t0 sg13_lv_pmos ad=55.5f pd=0.74u as=0.1005p ps=1.34u w=0.15u l=0.13u
X214 psdiff_2.buff_d8_1.VIN.t14 psdiff_2.CLKP.t8 VSS.t483 VSS.t454 sg13_lv_nmos ad=55.5f pd=0.74u as=0.1005p ps=1.34u w=0.15u l=0.13u
X215 VSS.t185 PH5.t12 PH2.t1 VSS.t184 sg13_lv_nmos ad=0.1005p pd=1.34u as=55.5f ps=0.74u w=0.15u l=0.13u
X216 VSS.t70 psdiff_2.VOUTDN psdiff_1.buff_d8_1.VIN.t15 VSS.t244 sg13_lv_nmos ad=55.5f pd=0.74u as=55.5f ps=0.74u w=0.15u l=0.13u
X217 VSS.t479 psdiff_2.CLKP.t8 psdiff_2.buff_d8_1.VIN.t13 VSS.t472 sg13_lv_nmos ad=55.5f pd=0.74u as=55.5f ps=0.74u w=0.15u l=0.13u
X218 psdiff_1.buff_d8_1.inv_d2_0.VIN psdiff_1.buff_d8_1.VIN.t32 VDD.t51 VDD.t33 sg13_lv_pmos ad=0.1005p pd=1.34u as=0.1005p ps=1.34u w=0.15u l=0.13u
X219 psdiff_0.buff_d8_0.VIN.t20 psdiff_1.VOUTDP VSS.t353 VSS.t331 sg13_lv_nmos ad=55.5f pd=0.74u as=55.5f ps=0.74u w=0.15u l=0.13u
X220 psdiff_1.buff_d8_1.VIN.t14 psdiff_2.VOUTDN VSS.t266 VSS.t242 sg13_lv_nmos ad=55.5f pd=0.74u as=55.5f ps=0.74u w=0.15u l=0.13u
X221 psdiff_0.buff_d8_0.VIN.t2 a_6005_1122# VDD.t116 VDD.t108 sg13_lv_pmos ad=55.5f pd=0.74u as=55.5f ps=0.74u w=0.15u l=0.13u
X222 VDD.t88 psdiff_2.buff_d8_1.inv_d8_0.VIN psdiff_2.VOUTDN VDD.t33 sg13_lv_pmos ad=0.1005p pd=1.34u as=55.5f ps=0.74u w=0.15u l=0.13u
X223 CTRL.t18 PH5.t10 CTRL.t18 VDD.t38 sg13_lv_pmos ad=0.19p pd=1.38u as=0 ps=0 w=1u l=0.13u
X224 VDD.t327 VSS.t611 psdiff_1.buff_d8_0.VIN.t30 VDD.t129 sg13_lv_pmos ad=55.5f pd=0.74u as=55.5f ps=0.74u w=0.15u l=0.13u
X225 VSS.t399 psdiff_2.CLKN psdiff_2.buff_d8_0.VIN.t15 VSS.t391 sg13_lv_nmos ad=55.5f pd=0.74u as=55.5f ps=0.74u w=0.15u l=0.13u
X226 PH5.t1 PH2.t12 VSS.t173 VSS.t172 sg13_lv_nmos ad=55.5f pd=0.74u as=0.1005p ps=1.34u w=0.15u l=0.13u
X227 VDD.t343 VSS.t611 psdiff_1.buff_d8_1.VIN.t19 VDD.t129 sg13_lv_pmos ad=55.5f pd=0.74u as=55.5f ps=0.74u w=0.15u l=0.13u
X228 psdiff_2.buff_d8_1.VIN.t31 a_1214_1266# VDD.t170 VDD.t169 sg13_lv_pmos ad=55.5f pd=0.74u as=55.5f ps=0.74u w=0.15u l=0.13u
X229 CTRL.t0 PH1.t11 CTRL.t0 VDD.t30 sg13_lv_pmos ad=0.19p pd=1.38u as=0 ps=0 w=1u l=0.13u
X230 psdiff_2.buff_d8_1.VIN.t28 a_1214_1266# VDD.t172 VDD.t169 sg13_lv_pmos ad=55.5f pd=0.74u as=55.5f ps=0.74u w=0.15u l=0.13u
X231 CTRL.t13 PH3.t10 CTRL.t13 VDD.t47 sg13_lv_pmos ad=0.19p pd=1.38u as=0 ps=0 w=1u l=0.13u
X232 CTRL.t18 PH2.t10 CTRL.t18 VDD.t41 sg13_lv_pmos ad=0.19p pd=1.38u as=0 ps=0 w=1u l=0.13u
X233 VDD.t326 VSS.t611 psdiff_1.buff_d8_1.VIN.t25 VDD.t129 sg13_lv_pmos ad=55.5f pd=0.74u as=55.5f ps=0.74u w=0.15u l=0.13u
X234 VSS.t527 buff_d8_5.inv_d8_0.VIN PH0.t6 VSS.t526 sg13_lv_nmos ad=0.1005p pd=1.34u as=55.5f ps=0.74u w=0.15u l=0.13u
X235 a_6005_1122# CTRL.t26 psdiff_0.buff_d8_1.VIN.t16 VSS.t89 sg13_lv_nmos ad=55.5f pd=0.74u as=0.1005p ps=1.34u w=0.15u l=0.13u
X236 CTRL.t16 PH5.t10 CTRL.t16 VDD.t36 sg13_lv_pmos ad=0.19p pd=1.38u as=0 ps=0 w=1u l=0.13u
X237 VSS.t553 buff_d8_3.inv_d8_0.VIN PH1.t6 VSS.t552 sg13_lv_nmos ad=0.1005p pd=1.34u as=55.5f ps=0.74u w=0.15u l=0.13u
X238 VSS.t9 psdiff_0.buff_d8_0.inv_d4_0.VIN psdiff_0.buff_d8_0.inv_d8_0.VIN VSS.t8 sg13_lv_nmos ad=0.1005p pd=1.34u as=55.5f ps=0.74u w=0.15u l=0.13u
X239 CTRL.t13 PH0.t10 CTRL.t13 VDD.t47 sg13_lv_pmos ad=0.19p pd=1.38u as=0 ps=0 w=1u l=0.13u
X240 VSS.t435 buff_d8_3.inv_d2_0.VIN buff_d8_3.inv_d4_0.VIN VSS.t434 sg13_lv_nmos ad=0.1005p pd=1.34u as=55.5f ps=0.74u w=0.15u l=0.13u
X241 psdiff_2.VOUTDP psdiff_2.buff_d8_0.inv_d8_0.VIN VSS.t39 VSS.t38 sg13_lv_nmos ad=55.5f pd=0.74u as=0.1005p ps=1.34u w=0.15u l=0.13u
X242 VDD.t276 VSS.t610 psdiff_2.buff_d8_1.VIN.t21 VDD.t169 sg13_lv_pmos ad=55.5f pd=0.74u as=55.5f ps=0.74u w=0.15u l=0.13u
X243 VDD.t367 VSS.t612 psdiff_0.buff_d8_0.VIN.t24 VDD.t108 sg13_lv_pmos ad=55.5f pd=0.74u as=55.5f ps=0.74u w=0.15u l=0.13u
X244 buff_d8_3.inv_d8_0.VIN buff_d8_3.inv_d4_0.VIN VSS.t537 VSS.t536 sg13_lv_nmos ad=55.5f pd=0.74u as=0.1005p ps=1.34u w=0.15u l=0.13u
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
