Fundacion-Fulgor/IHP__CDR4176/CDR4176-main/schematic/xschem/8xPI_top/8xPI_top_extracted.cir

* Extracted by KLayout with SG13G2 LVS runset on : 28/03/2026 20:09

.SUBCKT 8xPI_top VBN|VSS PH270|VIN|VINB|VIND|VINQB|VOUT VIN|VOUT VIN|VOUT$1
+ SQ[1]|VIN|VOUT|VS|VSN|VSP|VS[1] VOUT|VSN|VSP VIN|VINB|VOUT VOUT|VSN|VSP$1
+ VOUT|VSN|VSP$2 VIN|VOUT$2 VIN|VOUT$3 VIN|VOUT$4
+ STQ[7]|VIN|VOUT|VS|VSN|VSP|VST|VST[7] VOUT|VSN|VSP$3
+ PH90|VIN|VINA|VINC|VINQ|VOUT VOUT|VSN|VSP$4 VOUT|VSN|VSP$5 VIN|VOUT$5
+ VIN|VOUT$6 VIN|VOUT$7 VIN|VINA|VOUT VIN|VOUT$8
+ SQ[0]|VIN|VOUT|VS|VSN|VSP|VS[0] VOUT|VSN|VSP$6 VOUT|VSN|VSP$7 VOUT|VSN|VSP$8
+ CLKN|VIN|VOUT|VOUTDP VIN|VOUT$9 VIN|VOUT$10 VIN|VOUT$11
+ PH0|PH3|V3|VIN|VOUT|VOUTDP VIN|VOUT$12 PH0|PH1|V1|VIN|VOUT|VOUTDN VIN|VOUT$13
+ PH0|PH1|PH5|V5|VIN|VOUT|VOUTDP VIN|VOUT$14 VIN|VOUT$15 CLKN|VIN|VOUT|VOUTDP$1
+ CLKN|VIN|VOUT|VOUTDP$2 VIN|VOUT$16 VIN|VOUT$17 VIN|VOUT$18 VIN|VOUT$19
+ VIN|VOUT$20 VIN|VOUT$21 VBP|VDD PH0|VIN|VINA|VINI|VOUT VIN|VOUT$22
+ VIN|VOUT$23 VIN|VOUT$24 VIN|VOUT$25 VIN|VOUT$26 VIN|VOUT$27 VIN|VOUT$28
+ VIN|VOUT$29 VIN|VOUT$30 VIN|VOUT$31 VIN|VINB|VOUT$1 VOUT|VSN|VSP$9
+ VOUT|VSN|VSP$10 VOUT|VSN|VSP$11 VIN|VOUT$32 VIN VIN$1 VIN$2 VIN$3 VIN$4 VIN$5
+ VIN|VOUT$33 VIN|VOUT$34 VIN|VOUT$35 VIN|VOUT$36
+ STQ[6]|VIN|VOUT|VS|VSN|VSP|VST|VST[6] VOUT|VSN|VSP$12 VOUT|VSN|VSP$13
+ VOUT|VSN|VSP$14 VIN|VOUT$37 VIN|VOUT$38 VOUT|VSN|VSP$15 VIN|VINA|VOUT$1
+ VIN|VOUT$39 VIN|VOUT$40 VOUT|VSN|VSP$16 VOUT|VSN|VSP$17 VIN|VOUT$41
+ CLKP|VIN|VOUT|VOUTDN VIN|VOUT$42 CLKP|VIN|VOUT|VOUTDN$1 VIN|VOUT$43
+ CLKP|VIN|VOUT|VOUTDN$2 VIN|VOUT$44 VIN|VOUT$45 VIN|VOUT$46 VIN|VOUT$47
+ VIN|VOUT$48 VIN|VOUT$49 VIN|VOUT$50 VIN|VOUT$51 PH0|PH1|V0|VIN|VOUT|VOUTDN
+ PH0|PH1|PH4|V4|VIN|VOUT|VOUTDP PH1|PH2|V2|VIN|VOUT|VOUTDN VIN|VOUT$52
+ VIN|VOUT$53 VIN|VOUT$54 VIN|VOUT$55 VIN|VOUT$56 VIN|VOUT$57 VIN|VOUT$58
+ VIN|VOUT$59 VIN|VOUT$60 VIN|VOUT$61 VIN|VINB|VOUT$2 VIN|VOUT$62
+ VOUT|VSN|VSP$18 CTRL|VCONT VOUT|VSN|VSP$19 VOUT|VSN|VSP$20 VIN|VOUT$63
+ VIN|VOUT$64 VIN|VOUT$65 VIN|VOUT$66 STQ[5]|VIN|VOUT|VS|VSN|VSP|VST|VST[5]
+ VOUT|VSN|VSP$21 VOUT|VSN|VSP$22 VOUT|VSN|VSP$23 VIN|VOUT$67 VIN|VOUT$68
+ VIN|VINA|VOUT$2 VIN|VOUT$69 VIN|VOUT$70 VOUT|VSN|VSP$24 VOUT|VSN|VSP$25
+ VOUT|VSN|VSP$26 PH180|VIN|VINB|VINIB|VOUT VIN|VOUT$71 VIN|VOUT$72 VIN|VOUT$73
+ VIN|VOUT$74 VOUT|VSN|VSP$27 VIN|VINB|VOUT$3 VIN|VOUT$75 VOUT|VSN|VSP$28
+ VOUT|VSN|VSP$29 VIN|VOUT$76 VIN|VOUT$77 VIN|VOUT$78
+ STQ[4]|VIN|VOUT|VS|VSN|VSP|VST|VST[4] VOUT|VSN|VSP$30 VOUT|VSN|VSP$31
+ VIN|VOUT$79 PH1|VIN|VOUT VIN|VOUT$80 VIN|VOUT$81 VIN|VOUT$82 VOUT|VSN|VSP$32
+ VIN|VOUT$83 VIN|VOUT$84 VIN|VOUT$85 VIN|VINA|VOUT$3 VIN|VOUT$86 VIN|VOUT$87
+ VIN|VOUT$88 VOUT|VSN|VSP$33 VOUT|VSN|VSP$34 VOUT|VSN|VSP$35 VIN|VOUT$89
+ VIN|VOUT$90 VIN|VOUT$91 VIN|VOUT$92 VOUT VIN|VOUT$93 VIN|VOUT$94 VIN|VOUT$95
+ VIN|VOUT$96 VIN|VOUT$97 VIN|VINB|VOUT$4 VOUT|VSN|VSP$36 VOUT|VSN|VSP$37
+ PH0|VIN|VOUT VOUT|VSN|VSP$38 VIN|VOUT$98 VIN|VOUT$99 VIN|VOUT$100
+ VIN|VOUT$101 VIN|VOUT$102 VIN|VOUT$103 VIN|VOUT$104 VIN|VOUT$105
+ STQ[3]|VIN|VOUT|VS|VSN|VSP|VST|VST[3] VOUT|VSN|VSP$39 VOUT|VSN|VSP$40
+ VOUT|VSN|VSP$41 VIN|VOUT$106 VIN|VINA|VOUT$4 VIN|VOUT$107 VIN|VOUT$108
+ VOUT|VSN|VSP$42 VIN|VOUT$109 VIN|VOUT$110 VOUT|VSN|VSP$43 VOUT|VSN|VSP$44
+ VIN|VOUT$111 VIN|VOUT$112 VIN|VOUT$113 VIN|VOUT$114 VIN|VOUT$115
+ VIN|VINB|VOUT$5 VIN|VOUT$116 VIN|VOUT$117 VOUT|VSN|VSP$45 VOUT|VSN|VSP$46
+ VOUT|VSN|VSP$47 VOUT|VSN|VSS A|S[4]|VIN|VOUT|VS[4] B|S[3]|VDD|VIN|VSP|VS[3]
+ VIN|VOUT$118 VIN|VOUT$119 VIN|VOUT$120 VIN|VOUT$121 VIN|VOUT$122 VIN|VOUT$123
+ VIN|VOUT$124 STQ[2]|VIN|VOUT|VS|VSN|VSP|VST|VST[2] VOUT|VSN|VSP$48
+ VOUT|VSN|VSP$49 VOUT|VSN|VSP$50 VIN|VOUT$125 VIN|VINA|VOUT$5 VIN|VOUT$126
+ VIN|VOUT$127 VIN|VOUT$128 VOUT|VSN|VSP$51 VIN|VOUT$129 VOUT|VSN|VSP$52
+ VOUT|VSN|VSP$53 VIN|VOUT$130 VOUT|VSN|VSS$1 VIN|VOUT$131
+ B|OUT|ST[7]|VDD|VIN|VSP A|VIN|VOUT VIN|VOUT$132 VIN|VOUT$133 VIN|VOUT$134
+ VIN|VOUT$135 VIN|VOUT$136 VOUT|VSN|VSS$2 A|VIN|VOUT$1 B|OUT|ST[6]|VDD|VIN|VSP
+ VIN|VOUT$137 PH1|PHOUT|VIN|VOUT VIN|VOUT$138 VIN|VINB|VOUT$6 VIN|VOUT$139
+ VOUT|VSN|VSP$54 VOUT|VSN|VSP$55 PH0|PHOUT|VIN|VOUT VOUT|VSN|VSP$56
+ VIN|VOUT$140 VIN|VOUT$141 VIN|VOUT$142 VOUT|VSN|VSS$3 B|OUT|ST[5]|VDD|VIN|VSP
+ A|VIN|VOUT$2 VIN|VOUT$143 VIN|VOUT$144 VIN|VOUT$145 VIN|VOUT$146 VIN|VOUT$147
+ VIN|VOUT$148 VIN|VOUT$149 VIN|VOUT$150 STQ[1]|VIN|VOUT|VS|VSN|VSP|VST|VST[1]
+ VOUT|VSN|VSP$57 VOUT|VSN|VSP$58 VOUT|VSN|VSP$59 B|ST[4]|VDD|VIN|VOUT|VSP
+ VOUT|VSN|VSS$4 A|VIN|VOUT$3 VIN|VOUT$151 VIN|VOUT$152 VIN|VINA|VOUT$6
+ VIN|VOUT$153 VIN|VOUT$154 VOUT|VSN|VSP$60 VOUT|VSN|VSP$61 VIN|VOUT$155
+ VIN|VOUT$156 VOUT|VSN|VSP$62 VOUT|VSN|VSS$5 A|VIN|VOUT$4
+ B|OUT|ST[3]|VDD|VIN|VSP VIN|VOUT$157 VIN|VOUT$158 VIN|VOUT$159
+ B|OUT|ST[2]|VDD|VIN|VSP B|OUT|ST[1]|VDD|VIN|VSP VOUT|VSN|VSS$6 A|VIN|VOUT$5
+ A|OUT|VOUT VIN|VOUT$160 A|B|VOUT A|B|VOUT$1 B|C|VIN|VOUT VIN|VOUT$161
+ A|OUT|VOUT$1 VIN|VOUT$162 VOUT|VSN|VSP$63 VIN|VINB|VOUT$7 VOUT|VSN|VSP$64
+ VOUT|VSN|VSP$65 VOUT|VSN|VSS$7 A|VIN|VOUT$6 VIN|VOUT$163 OUT|VIN OUT|VIN$1
+ VIN|VOUT$164 VIN|VOUT$165 VIN|VOUT$166 SQ[2]|VIN|VOUT|VS|VSN|VSP|VST|VST[0]
+ VOUT|VSN|VSP$66 VOUT|VSN|VSP$67 VOUT|VSN|VSP$68 VIN|VOUT$167 VIN|VOUT$168
+ VIN|VINA|VOUT$7 VIN|VOUT$169 VIN|VOUT$170 VOUT|VSN|VSP$69 VOUT|VSN|VSP$70
+ VOUT|VSN|VSP$71 S[2]|VIN|VS[2] S[1]|VIN|VS[1] S[0]|VIN|VS[0] VIN|VOUT$171
+ VIN|VOUT$172 VIN|VOUT$173
M$1 VBN|VSS PH270|VIN|VINB|VIND|VINQB|VOUT VIN|VOUT VBN|VSS sg13_lv_nmos
+ L=0.13u W=0.3u AS=0.156p AD=0.156p PS=2.08u PD=2.08u
M$3 VIN|VOUT SQ[1]|VIN|VOUT|VS|VSN|VSP|VS[1] VIN|VOUT$1 VBN|VSS sg13_lv_nmos
+ L=0.13u W=0.15u AS=0.1005p AD=0.1005p PS=1.34u PD=1.34u
M$4 VIN|VOUT VOUT|VSN|VSP VIN|VOUT$1 VBN|VSS sg13_lv_nmos L=0.13u W=0.3u
+ AS=0.201p AD=0.201p PS=2.68u PD=2.68u
M$5 VBN|VSS \$16 VOUT|VSN|VSP VBN|VSS sg13_lv_nmos L=0.13u W=0.15u AS=0.1005p
+ AD=0.1005p PS=1.34u PD=1.34u
M$7 VIN|VOUT$1 VOUT|VSN|VSP$2 VIN|VINB|VOUT VBN|VSS sg13_lv_nmos L=0.13u
+ W=0.15u AS=0.1005p AD=0.1005p PS=1.34u PD=1.34u
M$8 VBN|VSS SQ[1]|VIN|VOUT|VS|VSN|VSP|VS[1] VOUT|VSN|VSP$1 VBN|VSS sg13_lv_nmos
+ L=0.13u W=0.15u AS=0.1005p AD=0.1005p PS=1.34u PD=1.34u
M$9 VBN|VSS PH90|VIN|VINA|VINC|VINQ|VOUT VIN|VOUT$5 VBN|VSS sg13_lv_nmos
+ L=0.13u W=0.3u AS=0.156p AD=0.156p PS=2.08u PD=2.08u
M$11 VIN|VOUT$5 VOUT|VSN|VSP$1 VIN|VOUT$2 VBN|VSS sg13_lv_nmos L=0.13u W=0.3u
+ AS=0.201p AD=0.201p PS=2.68u PD=2.68u
M$13 VBN|VSS \$24 \$24 VBN|VSS sg13_lv_nmos L=0.13u W=0.15u AS=0.1005p
+ AD=0.1005p PS=1.34u PD=1.34u
M$14 VIN|VOUT$5 VOUT|VSN|VSP VIN|VOUT$2 VBN|VSS sg13_lv_nmos L=0.13u W=0.15u
+ AS=0.1005p AD=0.1005p PS=1.34u PD=1.34u
M$15 VIN|VOUT$2 VOUT|VSN|VSP$2 VIN|VINB|VOUT VBN|VSS sg13_lv_nmos L=0.13u
+ W=0.15u AS=0.1005p AD=0.1005p PS=1.34u PD=1.34u
M$16 VBN|VSS VIN|VINB|VOUT VIN|VOUT$6 VBN|VSS sg13_lv_nmos L=0.13u W=0.3u
+ AS=0.156p AD=0.156p PS=2.08u PD=2.08u
M$18 VIN|VOUT$6 STQ[7]|VIN|VOUT|VS|VSN|VSP|VST|VST[7] VIN|VOUT$3 VBN|VSS
+ sg13_lv_nmos L=0.13u W=0.15u AS=0.1005p AD=0.1005p PS=1.34u PD=1.34u
M$19 VIN|VOUT$6 VOUT|VSN|VSP$3 VIN|VOUT$3 VBN|VSS sg13_lv_nmos L=0.13u W=0.3u
+ AS=0.201p AD=0.201p PS=2.68u PD=2.68u
M$20 VBN|VSS \$50 VOUT|VSN|VSP$3 VBN|VSS sg13_lv_nmos L=0.13u W=0.15u
+ AS=0.1005p AD=0.1005p PS=1.34u PD=1.34u
M$22 VIN|VOUT$3 VOUT|VSN|VSP$5 VIN|VOUT$4 VBN|VSS sg13_lv_nmos L=0.13u W=0.15u
+ AS=0.1005p AD=0.1005p PS=1.34u PD=1.34u
M$23 VBN|VSS PH180|VIN|VINB|VINIB|VOUT VIN|VOUT$9 VBN|VSS sg13_lv_nmos L=0.13u
+ W=0.3u AS=0.156p AD=0.156p PS=2.08u PD=2.08u
M$25 VIN|VOUT$9 SQ[0]|VIN|VOUT|VS|VSN|VSP|VS[0] VIN|VOUT$7 VBN|VSS sg13_lv_nmos
+ L=0.13u W=0.15u AS=0.1005p AD=0.1005p PS=1.34u PD=1.34u
M$26 VIN|VOUT$9 VOUT|VSN|VSP$6 VIN|VOUT$7 VBN|VSS sg13_lv_nmos L=0.13u W=0.3u
+ AS=0.201p AD=0.201p PS=2.68u PD=2.68u
M$27 VBN|VSS \$97 VOUT|VSN|VSP$6 VBN|VSS sg13_lv_nmos L=0.13u W=0.15u
+ AS=0.1005p AD=0.1005p PS=1.34u PD=1.34u
M$29 VIN|VOUT$7 VOUT|VSN|VSP$8 VIN|VINA|VOUT VBN|VSS sg13_lv_nmos L=0.13u
+ W=0.15u AS=0.1005p AD=0.1005p PS=1.34u PD=1.34u
M$30 VBN|VSS STQ[7]|VIN|VOUT|VS|VSN|VSP|VST|VST[7] VOUT|VSN|VSP$4 VBN|VSS
+ sg13_lv_nmos L=0.13u W=0.15u AS=0.1005p AD=0.1005p PS=1.34u PD=1.34u
M$31 VBN|VSS VIN|VINA|VOUT VIN|VOUT$10 VBN|VSS sg13_lv_nmos L=0.13u W=0.3u
+ AS=0.156p AD=0.156p PS=2.08u PD=2.08u
M$33 VIN|VOUT$10 VOUT|VSN|VSP$4 VIN|VOUT$8 VBN|VSS sg13_lv_nmos L=0.13u W=0.3u
+ AS=0.201p AD=0.201p PS=2.68u PD=2.68u
M$35 VBN|VSS \$74 \$74 VBN|VSS sg13_lv_nmos L=0.13u W=0.15u AS=0.1005p
+ AD=0.1005p PS=1.34u PD=1.34u
M$36 VIN|VOUT$10 VOUT|VSN|VSP$3 VIN|VOUT$8 VBN|VSS sg13_lv_nmos L=0.13u W=0.15u
+ AS=0.1005p AD=0.1005p PS=1.34u PD=1.34u
M$37 VIN|VOUT$8 VOUT|VSN|VSP$5 VIN|VOUT$4 VBN|VSS sg13_lv_nmos L=0.13u W=0.15u
+ AS=0.1005p AD=0.1005p PS=1.34u PD=1.34u
M$38 VBN|VSS CLKN|VIN|VOUT|VOUTDP VIN|VOUT$11 VBN|VSS sg13_lv_nmos L=0.13u
+ W=0.15u AS=0.1005p AD=0.1005p PS=1.34u PD=1.34u
M$39 VBN|VSS VIN|VOUT$11 VIN|VOUT$14 VBN|VSS sg13_lv_nmos L=0.13u W=0.3u
+ AS=0.156p AD=0.156p PS=2.08u PD=2.08u
M$41 VBN|VSS VIN|VOUT$14 VIN|VOUT$15 VBN|VSS sg13_lv_nmos L=0.13u W=0.6u
+ AS=0.312p AD=0.312p PS=4.16u PD=4.16u
M$45 VBN|VSS VIN|VOUT$15 PH0|PH3|V3|VIN|VOUT|VOUTDP VBN|VSS sg13_lv_nmos
+ L=0.13u W=1.2u AS=0.624p AD=0.624p PS=8.32u PD=8.32u
M$53 VBN|VSS CLKN|VIN|VOUT|VOUTDP$2 VIN|VOUT$12 VBN|VSS sg13_lv_nmos L=0.13u
+ W=0.15u AS=0.1005p AD=0.1005p PS=1.34u PD=1.34u
M$54 VBN|VSS VIN|VOUT$12 VIN|VOUT$16 VBN|VSS sg13_lv_nmos L=0.13u W=0.3u
+ AS=0.156p AD=0.156p PS=2.08u PD=2.08u
M$56 VBN|VSS VIN|VOUT$16 VIN|VOUT$17 VBN|VSS sg13_lv_nmos L=0.13u W=0.6u
+ AS=0.312p AD=0.312p PS=4.16u PD=4.16u
M$60 VBN|VSS VIN|VOUT$17 PH0|PH1|V1|VIN|VOUT|VOUTDN VBN|VSS sg13_lv_nmos
+ L=0.13u W=1.2u AS=0.624p AD=0.624p PS=8.32u PD=8.32u
M$68 VBN|VSS CLKN|VIN|VOUT|VOUTDP$1 VIN|VOUT$13 VBN|VSS sg13_lv_nmos L=0.13u
+ W=0.15u AS=0.1005p AD=0.1005p PS=1.34u PD=1.34u
M$69 VBN|VSS VIN|VOUT$13 VIN|VOUT$18 VBN|VSS sg13_lv_nmos L=0.13u W=0.3u
+ AS=0.156p AD=0.156p PS=2.08u PD=2.08u
M$71 VBN|VSS VIN|VOUT$18 VIN|VOUT$19 VBN|VSS sg13_lv_nmos L=0.13u W=0.6u
+ AS=0.312p AD=0.312p PS=4.16u PD=4.16u
M$75 VBN|VSS VIN|VOUT$19 PH0|PH1|PH5|V5|VIN|VOUT|VOUTDP VBN|VSS sg13_lv_nmos
+ L=0.13u W=1.2u AS=0.624p AD=0.624p PS=8.32u PD=8.32u
M$83 VBN|VSS SQ[0]|VIN|VOUT|VS|VSN|VSP|VS[0] VOUT|VSN|VSP$7 VBN|VSS
+ sg13_lv_nmos L=0.13u W=0.15u AS=0.1005p AD=0.1005p PS=1.34u PD=1.34u
M$84 VBN|VSS PH0|VIN|VINA|VINI|VOUT VIN|VOUT$20 VBN|VSS sg13_lv_nmos L=0.13u
+ W=0.3u AS=0.156p AD=0.156p PS=2.08u PD=2.08u
M$86 VIN|VOUT$20 VOUT|VSN|VSP$7 VIN|VOUT$21 VBN|VSS sg13_lv_nmos L=0.13u W=0.3u
+ AS=0.201p AD=0.201p PS=2.68u PD=2.68u
M$88 VBN|VSS \$135 \$135 VBN|VSS sg13_lv_nmos L=0.13u W=0.15u AS=0.1005p
+ AD=0.1005p PS=1.34u PD=1.34u
M$89 VIN|VOUT$20 VOUT|VSN|VSP$6 VIN|VOUT$21 VBN|VSS sg13_lv_nmos L=0.13u
+ W=0.15u AS=0.1005p AD=0.1005p PS=1.34u PD=1.34u
M$90 VIN|VOUT$21 VOUT|VSN|VSP$8 VIN|VINA|VOUT VBN|VSS sg13_lv_nmos L=0.13u
+ W=0.15u AS=0.1005p AD=0.1005p PS=1.34u PD=1.34u
M$91 VBN|VSS VIN|VOUT$22 CLKN|VIN|VOUT|VOUTDP VBN|VSS sg13_lv_nmos L=0.13u
+ W=1.2u AS=0.624p AD=0.624p PS=8.32u PD=8.32u
M$99 VBN|VSS VIN|VOUT$23 VIN|VOUT$22 VBN|VSS sg13_lv_nmos L=0.13u W=0.6u
+ AS=0.312p AD=0.312p PS=4.16u PD=4.16u
M$103 VBN|VSS VIN|VOUT$24 VIN|VOUT$23 VBN|VSS sg13_lv_nmos L=0.13u W=0.3u
+ AS=0.156p AD=0.156p PS=2.08u PD=2.08u
M$105 VIN|VOUT$24 VIN$1 VBN|VSS VBN|VSS sg13_lv_nmos L=0.13u W=0.15u AS=0.1005p
+ AD=0.1005p PS=1.34u PD=1.34u
M$106 VBN|VSS VIN|VOUT$25 CLKN|VIN|VOUT|VOUTDP$2 VBN|VSS sg13_lv_nmos L=0.13u
+ W=1.2u AS=0.624p AD=0.624p PS=8.32u PD=8.32u
M$114 VBN|VSS VIN|VOUT$26 VIN|VOUT$25 VBN|VSS sg13_lv_nmos L=0.13u W=0.6u
+ AS=0.312p AD=0.312p PS=4.16u PD=4.16u
M$118 VBN|VSS VIN|VOUT$27 VIN|VOUT$26 VBN|VSS sg13_lv_nmos L=0.13u W=0.3u
+ AS=0.156p AD=0.156p PS=2.08u PD=2.08u
M$120 VIN|VOUT$27 VIN$3 VBN|VSS VBN|VSS sg13_lv_nmos L=0.13u W=0.15u AS=0.1005p
+ AD=0.1005p PS=1.34u PD=1.34u
M$121 VBN|VSS VIN|VOUT$28 CLKN|VIN|VOUT|VOUTDP$1 VBN|VSS sg13_lv_nmos L=0.13u
+ W=1.2u AS=0.624p AD=0.624p PS=8.32u PD=8.32u
M$129 VBN|VSS VIN|VOUT$29 VIN|VOUT$28 VBN|VSS sg13_lv_nmos L=0.13u W=0.6u
+ AS=0.312p AD=0.312p PS=4.16u PD=4.16u
M$133 VBN|VSS VIN|VOUT$30 VIN|VOUT$29 VBN|VSS sg13_lv_nmos L=0.13u W=0.3u
+ AS=0.156p AD=0.156p PS=2.08u PD=2.08u
M$135 VIN|VOUT$30 VIN$5 VBN|VSS VBN|VSS sg13_lv_nmos L=0.13u W=0.15u AS=0.1005p
+ AD=0.1005p PS=1.34u PD=1.34u
M$136 VBN|VSS PH270|VIN|VINB|VIND|VINQB|VOUT VIN|VOUT$32 VBN|VSS sg13_lv_nmos
+ L=0.13u W=0.3u AS=0.156p AD=0.156p PS=2.08u PD=2.08u
M$138 VIN|VOUT$32 SQ[1]|VIN|VOUT|VS|VSN|VSP|VS[1] VIN|VOUT$31 VBN|VSS
+ sg13_lv_nmos L=0.13u W=0.15u AS=0.1005p AD=0.1005p PS=1.34u PD=1.34u
M$139 VIN|VOUT$32 VOUT|VSN|VSP$10 VIN|VOUT$31 VBN|VSS sg13_lv_nmos L=0.13u
+ W=0.3u AS=0.201p AD=0.201p PS=2.68u PD=2.68u
M$140 VBN|VSS \$991 VOUT|VSN|VSP$10 VBN|VSS sg13_lv_nmos L=0.13u W=0.15u
+ AS=0.1005p AD=0.1005p PS=1.34u PD=1.34u
M$142 VIN|VOUT$31 VOUT|VSN|VSP$11 VIN|VINB|VOUT$1 VBN|VSS sg13_lv_nmos L=0.13u
+ W=0.15u AS=0.1005p AD=0.1005p PS=1.34u PD=1.34u
M$143 VBN|VSS CLKP|VIN|VOUT|VOUTDN$2 VIN VBN|VSS sg13_lv_nmos L=0.13u W=4.5u
+ AS=1.8p AD=1.665p PS=24u PD=22.2u
M$153 VBN|VSS CLKN|VIN|VOUT|VOUTDP$1 VIN$1 VBN|VSS sg13_lv_nmos L=0.13u W=4.5u
+ AS=1.665p AD=1.8p PS=22.2u PD=24u
M$163 VBN|VSS CLKP|VIN|VOUT|VOUTDN VIN$2 VBN|VSS sg13_lv_nmos L=0.13u W=4.5u
+ AS=1.8p AD=1.665p PS=24u PD=22.2u
M$173 VBN|VSS CLKN|VIN|VOUT|VOUTDP VIN$3 VBN|VSS sg13_lv_nmos L=0.13u W=4.5u
+ AS=1.665p AD=1.8p PS=22.2u PD=24u
M$183 VBN|VSS CLKP|VIN|VOUT|VOUTDN$1 VIN$4 VBN|VSS sg13_lv_nmos L=0.13u W=4.5u
+ AS=1.8p AD=1.665p PS=24u PD=22.2u
M$193 VBN|VSS CLKN|VIN|VOUT|VOUTDP$2 VIN$5 VBN|VSS sg13_lv_nmos L=0.13u W=4.5u
+ AS=1.665p AD=1.8p PS=22.2u PD=24u
M$323 VBN|VSS SQ[1]|VIN|VOUT|VS|VSN|VSP|VS[1] VOUT|VSN|VSP$9 VBN|VSS
+ sg13_lv_nmos L=0.13u W=0.15u AS=0.1005p AD=0.1005p PS=1.34u PD=1.34u
M$324 VBN|VSS PH90|VIN|VINA|VINC|VINQ|VOUT VIN|VOUT$33 VBN|VSS sg13_lv_nmos
+ L=0.13u W=0.3u AS=0.156p AD=0.156p PS=2.08u PD=2.08u
M$326 VIN|VOUT$33 VOUT|VSN|VSP$9 VIN|VOUT$34 VBN|VSS sg13_lv_nmos L=0.13u
+ W=0.3u AS=0.201p AD=0.201p PS=2.68u PD=2.68u
M$328 VBN|VSS \$1284 \$1284 VBN|VSS sg13_lv_nmos L=0.13u W=0.15u AS=0.1005p
+ AD=0.1005p PS=1.34u PD=1.34u
M$329 VIN|VOUT$33 VOUT|VSN|VSP$10 VIN|VOUT$34 VBN|VSS sg13_lv_nmos L=0.13u
+ W=0.15u AS=0.1005p AD=0.1005p PS=1.34u PD=1.34u
M$330 VIN|VOUT$34 VOUT|VSN|VSP$11 VIN|VINB|VOUT$1 VBN|VSS sg13_lv_nmos L=0.13u
+ W=0.15u AS=0.1005p AD=0.1005p PS=1.34u PD=1.34u
M$331 VBN|VSS VIN|VINB|VOUT$1 VIN|VOUT$35 VBN|VSS sg13_lv_nmos L=0.13u W=0.3u
+ AS=0.156p AD=0.156p PS=2.08u PD=2.08u
M$333 VIN|VOUT$35 STQ[6]|VIN|VOUT|VS|VSN|VSP|VST|VST[6] VIN|VOUT$36 VBN|VSS
+ sg13_lv_nmos L=0.13u W=0.15u AS=0.1005p AD=0.1005p PS=1.34u PD=1.34u
M$334 VIN|VOUT$35 VOUT|VSN|VSP$12 VIN|VOUT$36 VBN|VSS sg13_lv_nmos L=0.13u
+ W=0.3u AS=0.201p AD=0.201p PS=2.68u PD=2.68u
M$335 VBN|VSS \$1321 VOUT|VSN|VSP$12 VBN|VSS sg13_lv_nmos L=0.13u W=0.15u
+ AS=0.1005p AD=0.1005p PS=1.34u PD=1.34u
M$337 VIN|VOUT$36 VOUT|VSN|VSP$14 VIN|VOUT$4 VBN|VSS sg13_lv_nmos L=0.13u
+ W=0.15u AS=0.1005p AD=0.1005p PS=1.34u PD=1.34u
M$338 VIN CTRL|VCONT \$1313 VBN|VSS sg13_lv_nmos L=0.13u W=0.3u AS=0.156p
+ AD=0.156p PS=2.08u PD=2.08u
M$340 VIN$1 CTRL|VCONT \$1314 VBN|VSS sg13_lv_nmos L=0.13u W=0.3u AS=0.156p
+ AD=0.156p PS=2.08u PD=2.08u
M$342 VIN$2 CTRL|VCONT \$1315 VBN|VSS sg13_lv_nmos L=0.13u W=0.3u AS=0.156p
+ AD=0.156p PS=2.08u PD=2.08u
M$344 VIN$3 CTRL|VCONT \$1316 VBN|VSS sg13_lv_nmos L=0.13u W=0.3u AS=0.156p
+ AD=0.156p PS=2.08u PD=2.08u
M$346 VIN$4 CTRL|VCONT \$1317 VBN|VSS sg13_lv_nmos L=0.13u W=0.3u AS=0.156p
+ AD=0.156p PS=2.08u PD=2.08u
M$348 VIN$5 CTRL|VCONT \$1318 VBN|VSS sg13_lv_nmos L=0.13u W=0.3u AS=0.156p
+ AD=0.156p PS=2.08u PD=2.08u
M$350 VBN|VSS PH180|VIN|VINB|VINIB|VOUT VIN|VOUT$37 VBN|VSS sg13_lv_nmos
+ L=0.13u W=0.3u AS=0.156p AD=0.156p PS=2.08u PD=2.08u
M$352 VIN|VOUT$37 SQ[0]|VIN|VOUT|VS|VSN|VSP|VS[0] VIN|VOUT$38 VBN|VSS
+ sg13_lv_nmos L=0.13u W=0.15u AS=0.1005p AD=0.1005p PS=1.34u PD=1.34u
M$353 VIN|VOUT$37 VOUT|VSN|VSP$15 VIN|VOUT$38 VBN|VSS sg13_lv_nmos L=0.13u
+ W=0.3u AS=0.201p AD=0.201p PS=2.68u PD=2.68u
M$354 VBN|VSS \$1397 VOUT|VSN|VSP$15 VBN|VSS sg13_lv_nmos L=0.13u W=0.15u
+ AS=0.1005p AD=0.1005p PS=1.34u PD=1.34u
M$356 VIN|VOUT$38 VOUT|VSN|VSP$17 VIN|VINA|VOUT$1 VBN|VSS sg13_lv_nmos L=0.13u
+ W=0.15u AS=0.1005p AD=0.1005p PS=1.34u PD=1.34u
M$357 VBN|VSS STQ[6]|VIN|VOUT|VS|VSN|VSP|VST|VST[6] VOUT|VSN|VSP$13 VBN|VSS
+ sg13_lv_nmos L=0.13u W=0.15u AS=0.1005p AD=0.1005p PS=1.34u PD=1.34u
M$358 VBN|VSS VIN|VINA|VOUT$1 VIN|VOUT$39 VBN|VSS sg13_lv_nmos L=0.13u W=0.3u
+ AS=0.156p AD=0.156p PS=2.08u PD=2.08u
M$360 VIN|VOUT$39 VOUT|VSN|VSP$13 VIN|VOUT$40 VBN|VSS sg13_lv_nmos L=0.13u
+ W=0.3u AS=0.201p AD=0.201p PS=2.68u PD=2.68u
M$362 VBN|VSS \$1370 \$1370 VBN|VSS sg13_lv_nmos L=0.13u W=0.15u AS=0.1005p
+ AD=0.1005p PS=1.34u PD=1.34u
M$363 VIN|VOUT$39 VOUT|VSN|VSP$12 VIN|VOUT$40 VBN|VSS sg13_lv_nmos L=0.13u
+ W=0.15u AS=0.1005p AD=0.1005p PS=1.34u PD=1.34u
M$364 VIN|VOUT$40 VOUT|VSN|VSP$14 VIN|VOUT$4 VBN|VSS sg13_lv_nmos L=0.13u
+ W=0.15u AS=0.1005p AD=0.1005p PS=1.34u PD=1.34u
M$365 VBN|VSS VIN VIN|VOUT$41 VBN|VSS sg13_lv_nmos L=0.13u W=0.15u AS=0.1005p
+ AD=0.1005p PS=1.34u PD=1.34u
M$366 VBN|VSS VIN|VOUT$41 VIN|VOUT$44 VBN|VSS sg13_lv_nmos L=0.13u W=0.3u
+ AS=0.156p AD=0.156p PS=2.08u PD=2.08u
M$368 VBN|VSS VIN|VOUT$44 VIN|VOUT$45 VBN|VSS sg13_lv_nmos L=0.13u W=0.6u
+ AS=0.312p AD=0.312p PS=4.16u PD=4.16u
M$372 VBN|VSS VIN|VOUT$45 CLKP|VIN|VOUT|VOUTDN VBN|VSS sg13_lv_nmos L=0.13u
+ W=1.2u AS=0.624p AD=0.624p PS=8.32u PD=8.32u
M$380 VBN|VSS VIN$2 VIN|VOUT$42 VBN|VSS sg13_lv_nmos L=0.13u W=0.15u AS=0.1005p
+ AD=0.1005p PS=1.34u PD=1.34u
M$381 VBN|VSS VIN|VOUT$42 VIN|VOUT$46 VBN|VSS sg13_lv_nmos L=0.13u W=0.3u
+ AS=0.156p AD=0.156p PS=2.08u PD=2.08u
M$383 VBN|VSS VIN|VOUT$46 VIN|VOUT$47 VBN|VSS sg13_lv_nmos L=0.13u W=0.6u
+ AS=0.312p AD=0.312p PS=4.16u PD=4.16u
M$387 VBN|VSS VIN|VOUT$47 CLKP|VIN|VOUT|VOUTDN$1 VBN|VSS sg13_lv_nmos L=0.13u
+ W=1.2u AS=0.624p AD=0.624p PS=8.32u PD=8.32u
M$395 VBN|VSS VIN$4 VIN|VOUT$43 VBN|VSS sg13_lv_nmos L=0.13u W=0.15u AS=0.1005p
+ AD=0.1005p PS=1.34u PD=1.34u
M$396 VBN|VSS VIN|VOUT$43 VIN|VOUT$48 VBN|VSS sg13_lv_nmos L=0.13u W=0.3u
+ AS=0.156p AD=0.156p PS=2.08u PD=2.08u
M$398 VBN|VSS VIN|VOUT$48 VIN|VOUT$49 VBN|VSS sg13_lv_nmos L=0.13u W=0.6u
+ AS=0.312p AD=0.312p PS=4.16u PD=4.16u
M$402 VBN|VSS VIN|VOUT$49 CLKP|VIN|VOUT|VOUTDN$2 VBN|VSS sg13_lv_nmos L=0.13u
+ W=1.2u AS=0.624p AD=0.624p PS=8.32u PD=8.32u
M$410 VBN|VSS SQ[0]|VIN|VOUT|VS|VSN|VSP|VS[0] VOUT|VSN|VSP$16 VBN|VSS
+ sg13_lv_nmos L=0.13u W=0.15u AS=0.1005p AD=0.1005p PS=1.34u PD=1.34u
M$411 VBN|VSS PH0|VIN|VINA|VINI|VOUT VIN|VOUT$51 VBN|VSS sg13_lv_nmos L=0.13u
+ W=0.3u AS=0.156p AD=0.156p PS=2.08u PD=2.08u
M$413 VIN|VOUT$51 VOUT|VSN|VSP$16 VIN|VOUT$50 VBN|VSS sg13_lv_nmos L=0.13u
+ W=0.3u AS=0.201p AD=0.201p PS=2.68u PD=2.68u
M$415 VBN|VSS \$1700 \$1700 VBN|VSS sg13_lv_nmos L=0.13u W=0.15u AS=0.1005p
+ AD=0.1005p PS=1.34u PD=1.34u
M$416 VIN|VOUT$51 VOUT|VSN|VSP$15 VIN|VOUT$50 VBN|VSS sg13_lv_nmos L=0.13u
+ W=0.15u AS=0.1005p AD=0.1005p PS=1.34u PD=1.34u
M$417 VIN|VOUT$50 VOUT|VSN|VSP$17 VIN|VINA|VOUT$1 VBN|VSS sg13_lv_nmos L=0.13u
+ W=0.15u AS=0.1005p AD=0.1005p PS=1.34u PD=1.34u
M$418 VBN|VSS VIN|VOUT$52 PH0|PH1|V0|VIN|VOUT|VOUTDN VBN|VSS sg13_lv_nmos
+ L=0.13u W=1.2u AS=0.624p AD=0.624p PS=8.32u PD=8.32u
M$426 VBN|VSS VIN|VOUT$53 VIN|VOUT$52 VBN|VSS sg13_lv_nmos L=0.13u W=0.6u
+ AS=0.312p AD=0.312p PS=4.16u PD=4.16u
M$430 VBN|VSS VIN|VOUT$54 VIN|VOUT$53 VBN|VSS sg13_lv_nmos L=0.13u W=0.3u
+ AS=0.156p AD=0.156p PS=2.08u PD=2.08u
M$432 VIN|VOUT$54 CLKP|VIN|VOUT|VOUTDN VBN|VSS VBN|VSS sg13_lv_nmos L=0.13u
+ W=0.15u AS=0.1005p AD=0.1005p PS=1.34u PD=1.34u
M$433 VBN|VSS VIN|VOUT$55 PH0|PH1|PH4|V4|VIN|VOUT|VOUTDP VBN|VSS sg13_lv_nmos
+ L=0.13u W=1.2u AS=0.624p AD=0.624p PS=8.32u PD=8.32u
M$441 VBN|VSS VIN|VOUT$56 VIN|VOUT$55 VBN|VSS sg13_lv_nmos L=0.13u W=0.6u
+ AS=0.312p AD=0.312p PS=4.16u PD=4.16u
M$445 VBN|VSS VIN|VOUT$57 VIN|VOUT$56 VBN|VSS sg13_lv_nmos L=0.13u W=0.3u
+ AS=0.156p AD=0.156p PS=2.08u PD=2.08u
M$447 VIN|VOUT$57 CLKP|VIN|VOUT|VOUTDN$1 VBN|VSS VBN|VSS sg13_lv_nmos L=0.13u
+ W=0.15u AS=0.1005p AD=0.1005p PS=1.34u PD=1.34u
M$448 VBN|VSS VIN|VOUT$58 PH1|PH2|V2|VIN|VOUT|VOUTDN VBN|VSS sg13_lv_nmos
+ L=0.13u W=1.2u AS=0.624p AD=0.624p PS=8.32u PD=8.32u
M$456 VBN|VSS VIN|VOUT$59 VIN|VOUT$58 VBN|VSS sg13_lv_nmos L=0.13u W=0.6u
+ AS=0.312p AD=0.312p PS=4.16u PD=4.16u
M$460 VBN|VSS VIN|VOUT$60 VIN|VOUT$59 VBN|VSS sg13_lv_nmos L=0.13u W=0.3u
+ AS=0.156p AD=0.156p PS=2.08u PD=2.08u
M$462 VIN|VOUT$60 CLKP|VIN|VOUT|VOUTDN$2 VBN|VSS VBN|VSS sg13_lv_nmos L=0.13u
+ W=0.15u AS=0.1005p AD=0.1005p PS=1.34u PD=1.34u
M$463 VBN|VSS PH270|VIN|VINB|VIND|VINQB|VOUT VIN|VOUT$62 VBN|VSS sg13_lv_nmos
+ L=0.13u W=0.3u AS=0.156p AD=0.156p PS=2.08u PD=2.08u
M$465 VIN|VOUT$62 SQ[1]|VIN|VOUT|VS|VSN|VSP|VS[1] VIN|VOUT$61 VBN|VSS
+ sg13_lv_nmos L=0.13u W=0.15u AS=0.1005p AD=0.1005p PS=1.34u PD=1.34u
M$466 VIN|VOUT$62 VOUT|VSN|VSP$18 VIN|VOUT$61 VBN|VSS sg13_lv_nmos L=0.13u
+ W=0.3u AS=0.201p AD=0.201p PS=2.68u PD=2.68u
M$467 VBN|VSS \$2560 VOUT|VSN|VSP$18 VBN|VSS sg13_lv_nmos L=0.13u W=0.15u
+ AS=0.1005p AD=0.1005p PS=1.34u PD=1.34u
M$469 VIN|VOUT$61 VOUT|VSN|VSP$20 VIN|VINB|VOUT$2 VBN|VSS sg13_lv_nmos L=0.13u
+ W=0.15u AS=0.1005p AD=0.1005p PS=1.34u PD=1.34u
M$470 VBN|VSS SQ[1]|VIN|VOUT|VS|VSN|VSP|VS[1] VOUT|VSN|VSP$19 VBN|VSS
+ sg13_lv_nmos L=0.13u W=0.15u AS=0.1005p AD=0.1005p PS=1.34u PD=1.34u
M$471 VBN|VSS PH90|VIN|VINA|VINC|VINQ|VOUT VIN|VOUT$63 VBN|VSS sg13_lv_nmos
+ L=0.13u W=0.3u AS=0.156p AD=0.156p PS=2.08u PD=2.08u
M$473 VIN|VOUT$63 VOUT|VSN|VSP$19 VIN|VOUT$64 VBN|VSS sg13_lv_nmos L=0.13u
+ W=0.3u AS=0.201p AD=0.201p PS=2.68u PD=2.68u
M$475 VBN|VSS \$2581 \$2581 VBN|VSS sg13_lv_nmos L=0.13u W=0.15u AS=0.1005p
+ AD=0.1005p PS=1.34u PD=1.34u
M$476 VIN|VOUT$63 VOUT|VSN|VSP$18 VIN|VOUT$64 VBN|VSS sg13_lv_nmos L=0.13u
+ W=0.15u AS=0.1005p AD=0.1005p PS=1.34u PD=1.34u
M$477 VIN|VOUT$64 VOUT|VSN|VSP$20 VIN|VINB|VOUT$2 VBN|VSS sg13_lv_nmos L=0.13u
+ W=0.15u AS=0.1005p AD=0.1005p PS=1.34u PD=1.34u
M$478 VBN|VSS VIN|VINB|VOUT$2 VIN|VOUT$65 VBN|VSS sg13_lv_nmos L=0.13u W=0.3u
+ AS=0.156p AD=0.156p PS=2.08u PD=2.08u
M$480 VIN|VOUT$65 STQ[5]|VIN|VOUT|VS|VSN|VSP|VST|VST[5] VIN|VOUT$66 VBN|VSS
+ sg13_lv_nmos L=0.13u W=0.15u AS=0.1005p AD=0.1005p PS=1.34u PD=1.34u
M$481 VIN|VOUT$65 VOUT|VSN|VSP$21 VIN|VOUT$66 VBN|VSS sg13_lv_nmos L=0.13u
+ W=0.3u AS=0.201p AD=0.201p PS=2.68u PD=2.68u
M$482 VBN|VSS \$2618 VOUT|VSN|VSP$21 VBN|VSS sg13_lv_nmos L=0.13u W=0.15u
+ AS=0.1005p AD=0.1005p PS=1.34u PD=1.34u
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
