Fundacion-Fulgor/IHP__CDR4176/(commit log)

2026-09-14 feat: Top module layout with connections to the Pad-Frame
2026-09-14 refactor: organize CDR4176 sources and portable EDA flow
    Colocate PEX with recovered historical source; remove deprecated 2to4 and DRC decks plus generated outputs from the active tree while preserving history and the immutable release.
    No electrical signoff is claimed: two pre-existing TB floating nets remain, and compiled OSDI is an external requirement.
    [3to7_deco.sch, 3to7_deco_v2.sch, 4to4.sch, 6ph_rosc.sch, 6to4.sch, 8xPI.sch, 8xPI_logic.sch, 8xPI_top.sch]
2026-09-15 fix: Connected VDD wire to the TopMetal2 of the VDD IOCell
2026-09-17 fix: updated top view from main/layout/ to version with external wires
2026-09-18 fix(paths): harden Xschem path fixer and add fixer CI check
    [test_fix_xschem_paths.py]
2026-09-18 feat: Add power grid and improve connections to the Pads
2026-09-19 fix: restore CDR4176 layout to its DRC (inc. antenna) and LVS clean version
2026-09-20 fix: Fixed 8xPI sch_n_sym and CDR4176 sch to pass deep LVS
    [8xPI_top.sch, CDR4176.sch]
2026-09-20 fix: Delete erroneous VDD TM2 text on VSS PowGrid wire
2026-09-21 fix: Modify schematic to not collide with other projects name cells. LVS purposes
    [3to7_deco_v2.sch, 8xPI.sch, 8xPI_logic.sch, MUX_2_1_CDR.sch, MUX_4_1_CDR.sch, and_custom.sch, buff_d8.sch, div_freq_x2.sch]
2026-09-21 fix(paths): ignore generated SPICE comments
    [test_fix_xschem_paths.py]
2026-09-21 fix(paths): separate portability checks from dependency audits
    [test_check_xschem_paths.py, test_eda.py, test_hierarchical_paths.py]
2026-09-22 chore: deletion of deprecated modules 3to7_deco and 4to4 and proyect.yml
    [3to7_deco.sch, 4to4.sch]
2026-10-01 test: Added 2 pex testbenches and verification platforms
    [tb_3to7_deco_tran.sch, tb_3to7_deco_v2_tran.sch, tb_6ph_rosc.sch, tb_6ph_rosc_pex.sch, tb_8xPI.sch, tb_8xPI_pex.sch, tb_8xPI_top_pex.sch, tb_8xpi_io_cells.sch]
